stebenpe/MobileManipulator/besturingskast/README.md

# Besturingskast


## 1. Onderdelen
1. Omron NX-SL3300 1X
2. Omron NX-SID800 2X
3. Omron NX-SOD400 2X
4. Omron NX-EIC202 1X
5. Omron G7SA-2A2B DC24 met din-rail houder 6X
6. 12V 10A DC-DC converter 1X
7. 24V 5A DC-DC converter 1X
8. Kabelgoot 1X
9. NVIDIA Jetson AGX orin 1X

## 2. E-Plan
Voor de safety PLC, LD-90 en robot arm is een E-Plan tekening gemaakt. Deze is te vinden in de map e-plan.

## 3. Aanpassingen
In de stroom splitsing.docx is uitleg te vinden over de aanpassingen van de voeding splitsing voor de robot arm. Hier staan ook de benodigde onderdelen daarvoor in.
