stebenpe/MobileManipulator/images/programma-overzicht.jpg

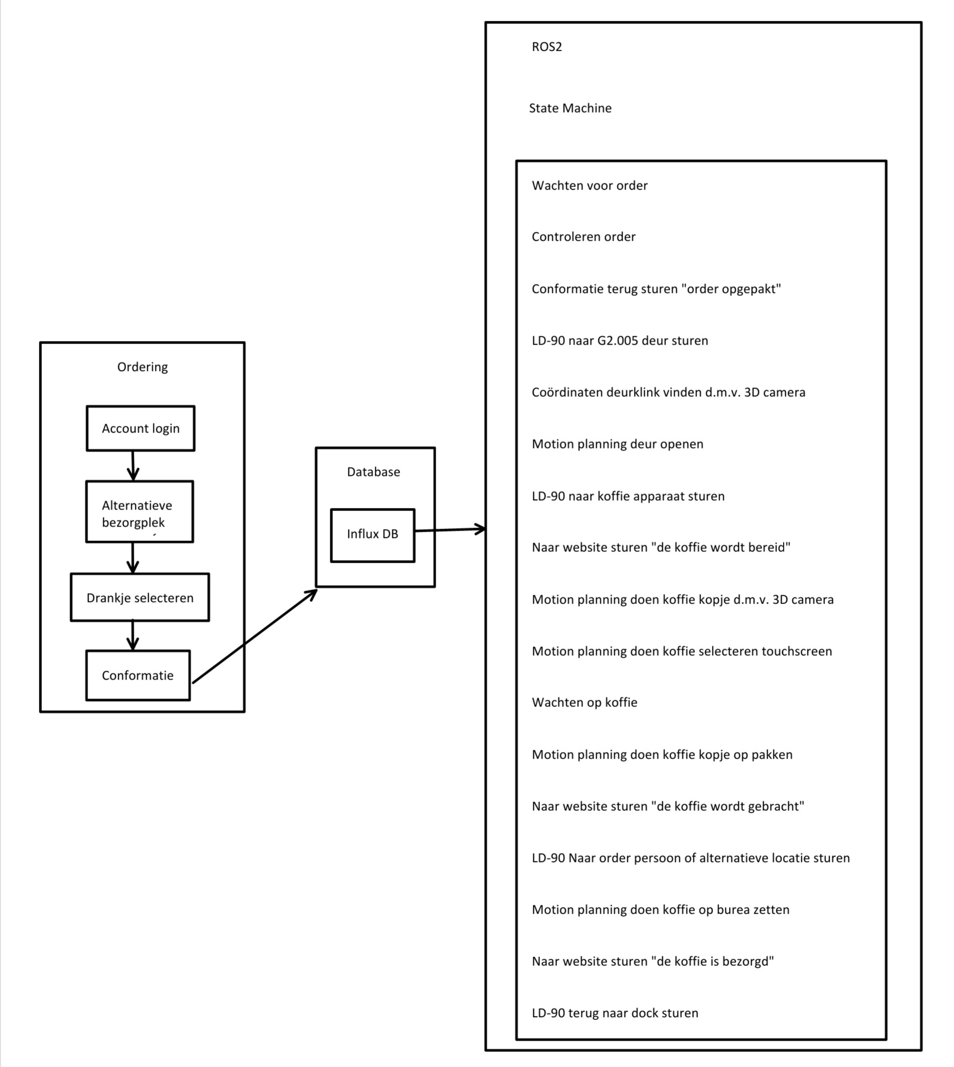
images/programma-overzicht.jpg
