stebenpe/MobileManipulator/maak onderdelen/3D prints/sensor blok M V1.2.STL

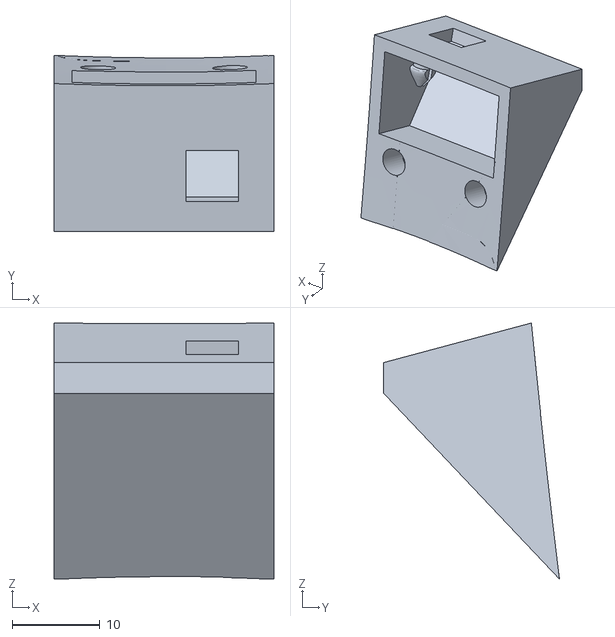
[picture p22: CAD file, 2023-12-12, last stored version]
maak onderdelen/3D prints/sensor blok M V1.2.STL
25.0 x 20.0 x 29.1
