stebenpe/MobileManipulator/maak onderdelen/watersnijden/top top plate ld90 6mm.DXF

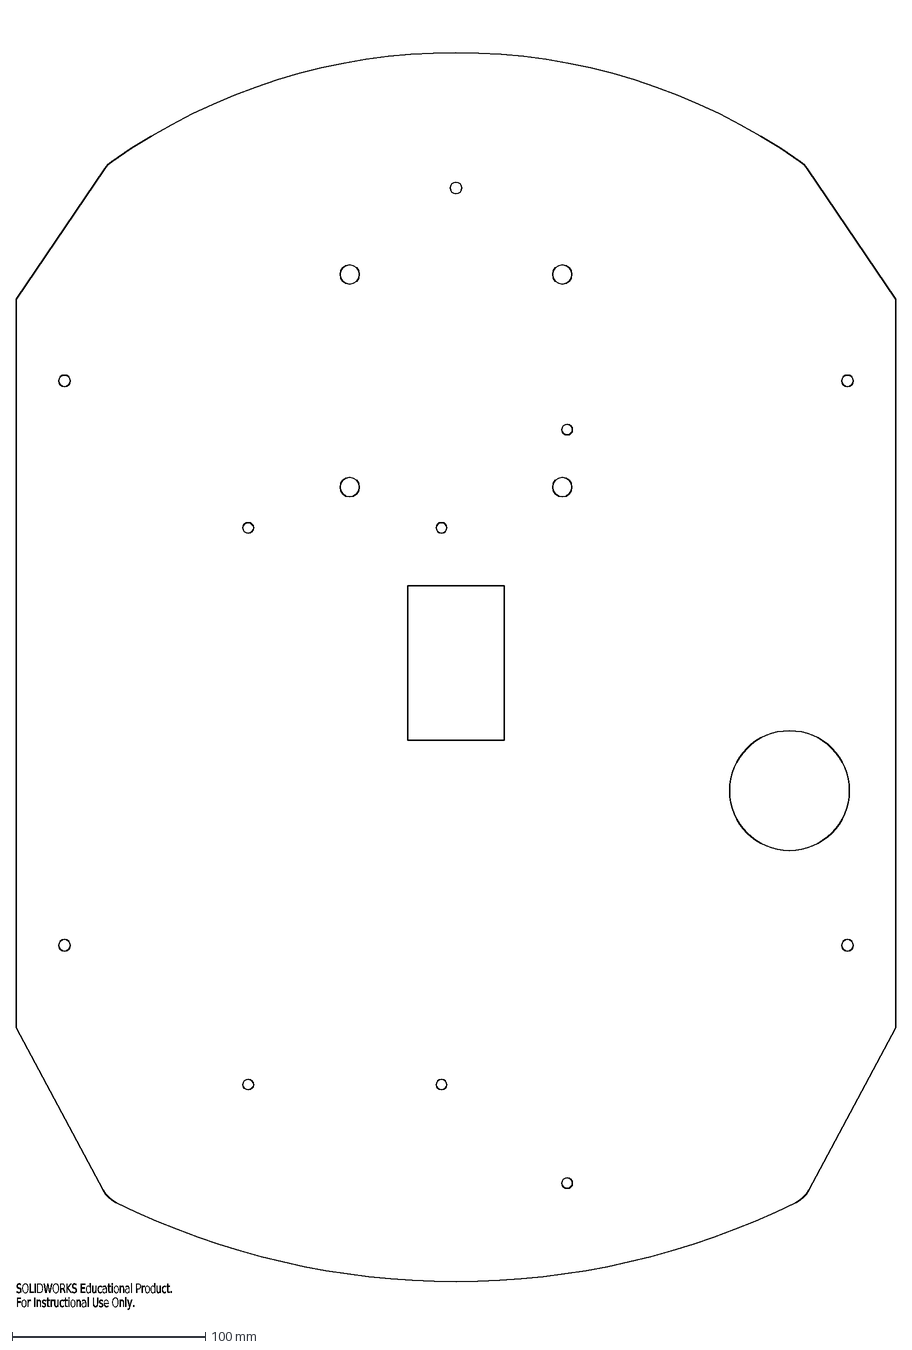
[picture p23: CAD file, 2023-12-11, last stored version]
maak onderdelen/watersnijden/top top plate ld90 6mm.DXF
SOLIDWORKS Educational Product.
For Instructional Use Only.
