stebenpe/MobileManipulator/ros2_ws/src/assets/end_effectors/robotiq_3f_gripper/robotiq_3f_gripper_description/meshes/robotiq-3f-gripper/collision/GRIPPER_OPEN_PALM.stl

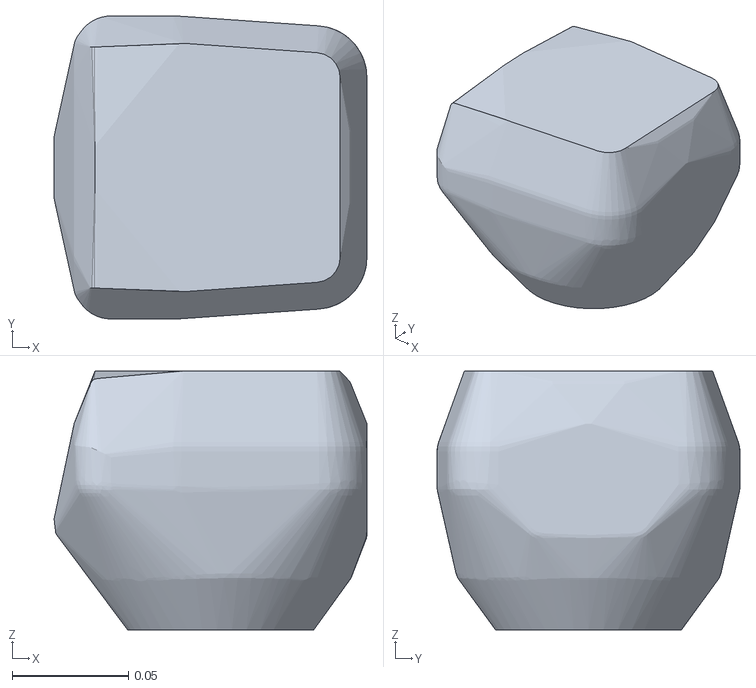
[picture p24: CAD file, 2023-12-11, last stored version]
ros2_ws/src/assets/end_effectors/robotiq_3f_gripper/robotiq_3f_gripper_description/meshes/robotiq-3f-gripper/collision/GRIPPER_OPEN_PALM.stl
0.134 x 0.13 x 0.111
