stebenpe/MobileManipulator/ros2_ws/src/assets/end_effectors/robotiq_3f_gripper/robotiq_3f_gripper_description/meshes/robotiq-3f-gripper/visual/GRIPPER_OPEN_FINGER_1.stl

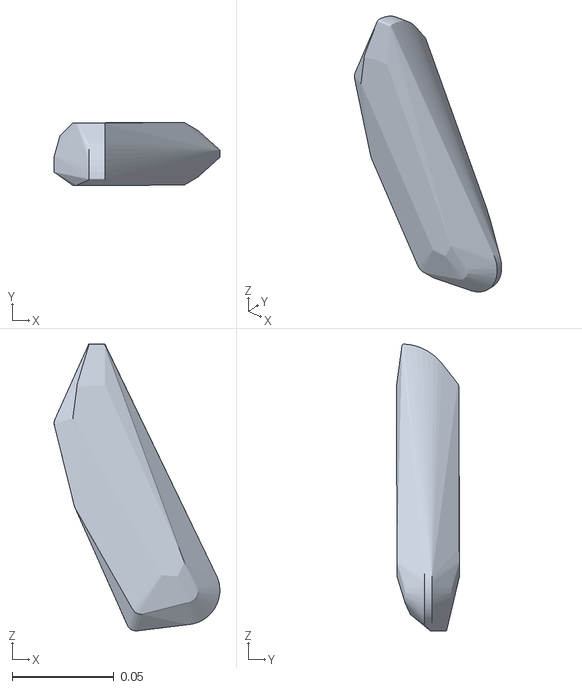
[picture p25: CAD file, 2023-12-11, last stored version]
ros2_ws/src/assets/end_effectors/robotiq_3f_gripper/robotiq_3f_gripper_description/meshes/robotiq-3f-gripper/visual/GRIPPER_OPEN_FINGER_1.stl
0.0815 x 0.031 x 0.141
