stebenpe/MobileManipulator/ros2_ws/src/assets/end_effectors/robotiq_3f_gripper/robotiq_3f_gripper_description/meshes/robotiq-3f-gripper_articulated/collision/link_0.STL

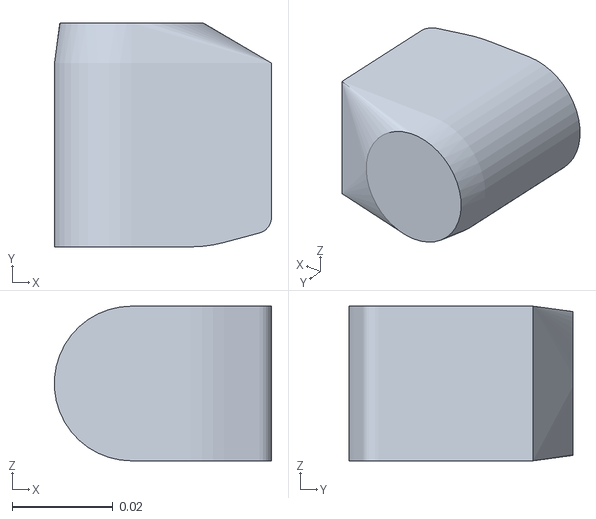
[picture p26: CAD file, 2023-12-11, last stored version]
ros2_ws/src/assets/end_effectors/robotiq_3f_gripper/robotiq_3f_gripper_description/meshes/robotiq-3f-gripper_articulated/collision/link_0.STL
0.0431 x 0.0444 x 0.0307
