stebenpe/MobileManipulator/ros2_ws/src/assets/end_effectors/robotiq_85_gripper/robotiq_85_description/meshes/collision/robotiq_85_base_link.stl

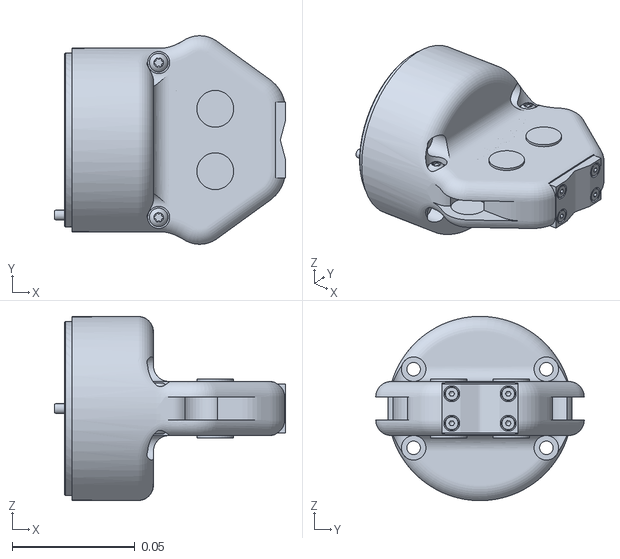
[picture p27: CAD file, 2023-12-11, last stored version]
ros2_ws/src/assets/end_effectors/robotiq_85_gripper/robotiq_85_description/meshes/collision/robotiq_85_base_link.stl
0.094 x 0.0849 x 0.075
