stebenpe/MobileManipulator/ros2_ws/src/assets/end_effectors/single_suction_gripper/single_suction_description/meshes/wrist_fixture.STL

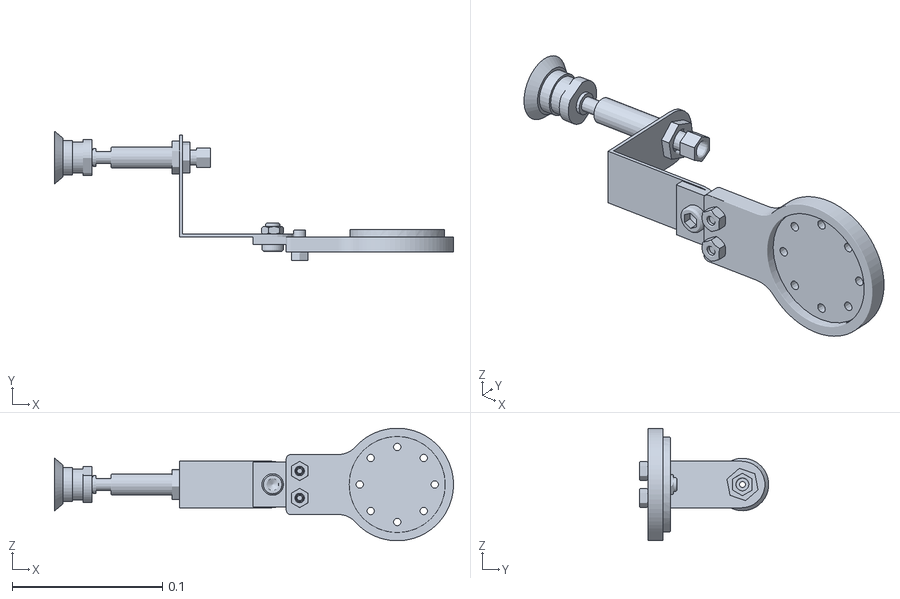
[picture p28: CAD file, 2023-12-11, last stored version]
ros2_ws/src/assets/end_effectors/single_suction_gripper/single_suction_description/meshes/wrist_fixture.STL
0.266 x 0.0862 x 0.0749
