stebenpe/MobileManipulator/ros2_ws/src/assets/robots/fanuc/fanuc_description/meshes/collision/link_1.stl

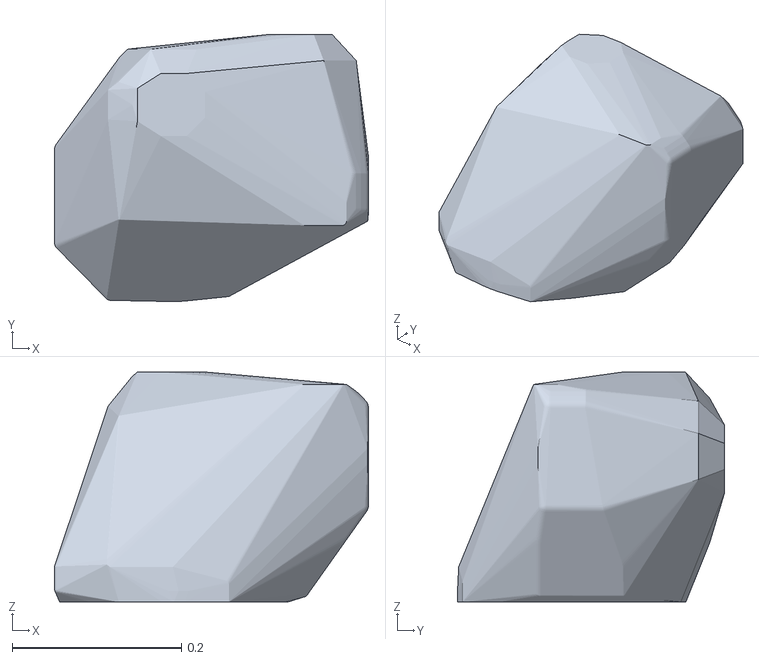
[picture p29: CAD file, 2023-12-11, last stored version]
ros2_ws/src/assets/robots/fanuc/fanuc_description/meshes/collision/link_1.stl
0.371 x 0.316 x 0.272
