stebenpe/MobileManipulator/ros2_ws/src/assets/robots/fanuc/fanuc_description/meshes/visual/link_2.stl

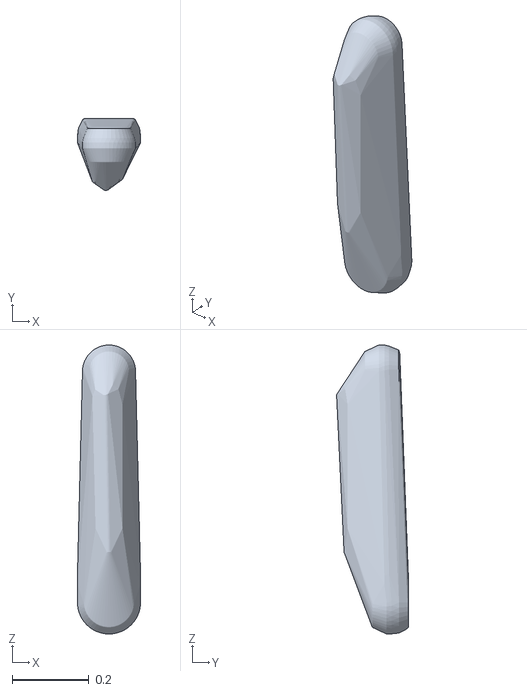
[picture p30: CAD file, 2023-12-11, last stored version]
ros2_ws/src/assets/robots/fanuc/fanuc_description/meshes/visual/link_2.stl
0.164 x 0.187 x 0.751
