stebenpe/MobileManipulator/ros2_ws/src/assets/robots/panda_robot/panda_description/meshes/collision/link1.stl

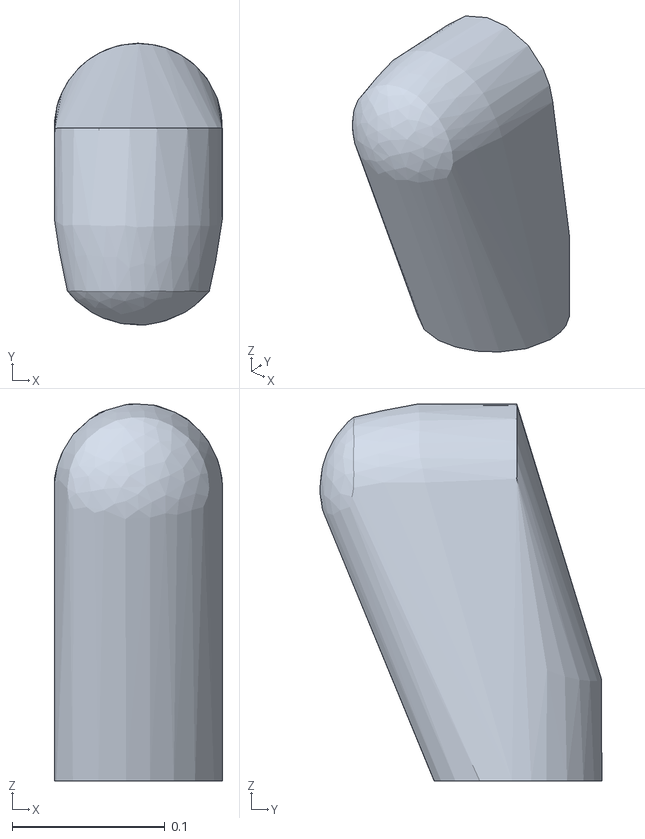
[picture p31: CAD file, 2023-12-11, last stored version]
ros2_ws/src/assets/robots/panda_robot/panda_description/meshes/collision/link1.stl
0.11 x 0.185 x 0.247
