stebenpe/MobileManipulator/ros2_ws/src/assets/robots/universal_robot/ur_description/meshes/ur10/collision/wrist2.stl

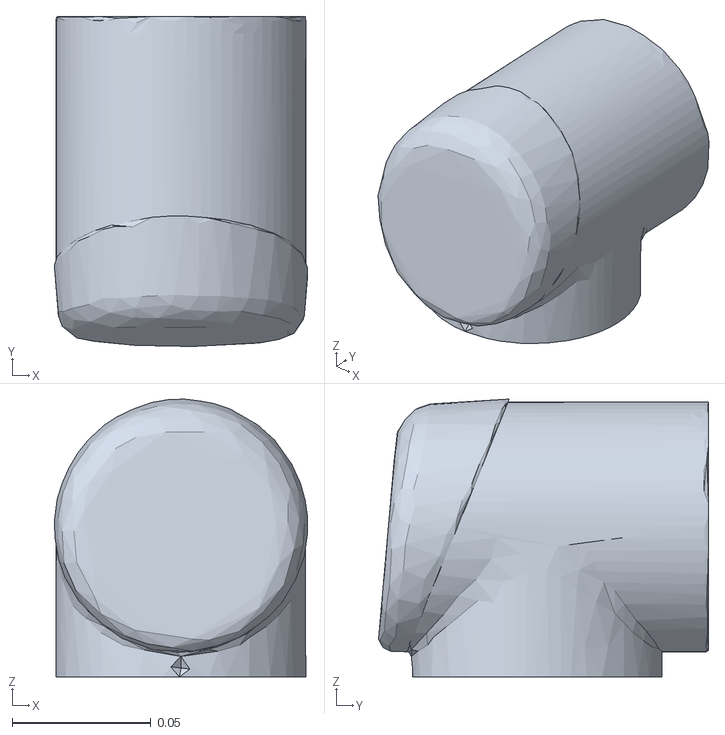
[picture p32: CAD file, 2023-12-11, last stored version]
ros2_ws/src/assets/robots/universal_robot/ur_description/meshes/ur10/collision/wrist2.stl
0.0913 x 0.119 x 0.1
