stebenpe/MobileManipulator/ros2_ws/src/assets/robots/universal_robot/ur_description/meshes/ur3/collision/shoulder.stl

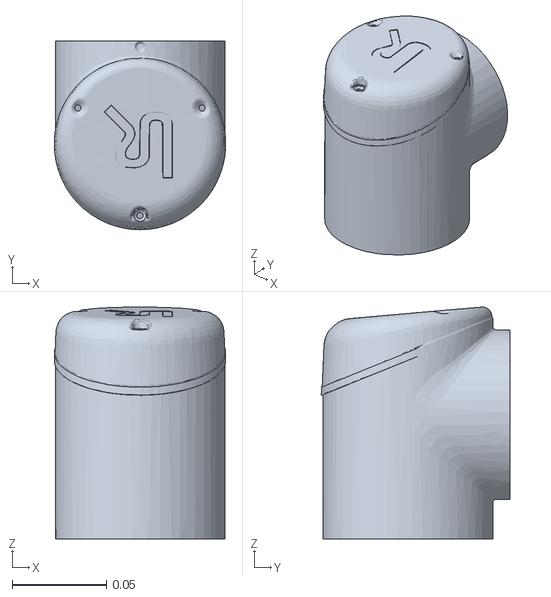
[picture p33: CAD file, 2023-12-11, last stored version]
ros2_ws/src/assets/robots/universal_robot/ur_description/meshes/ur3/collision/shoulder.stl
0.0909 x 0.0999 x 0.123
