stebenpe/MobileManipulator/ros2_ws/src/assets/robots/universal_robot/ur_description/meshes/ur5/collision/wrist3.stl

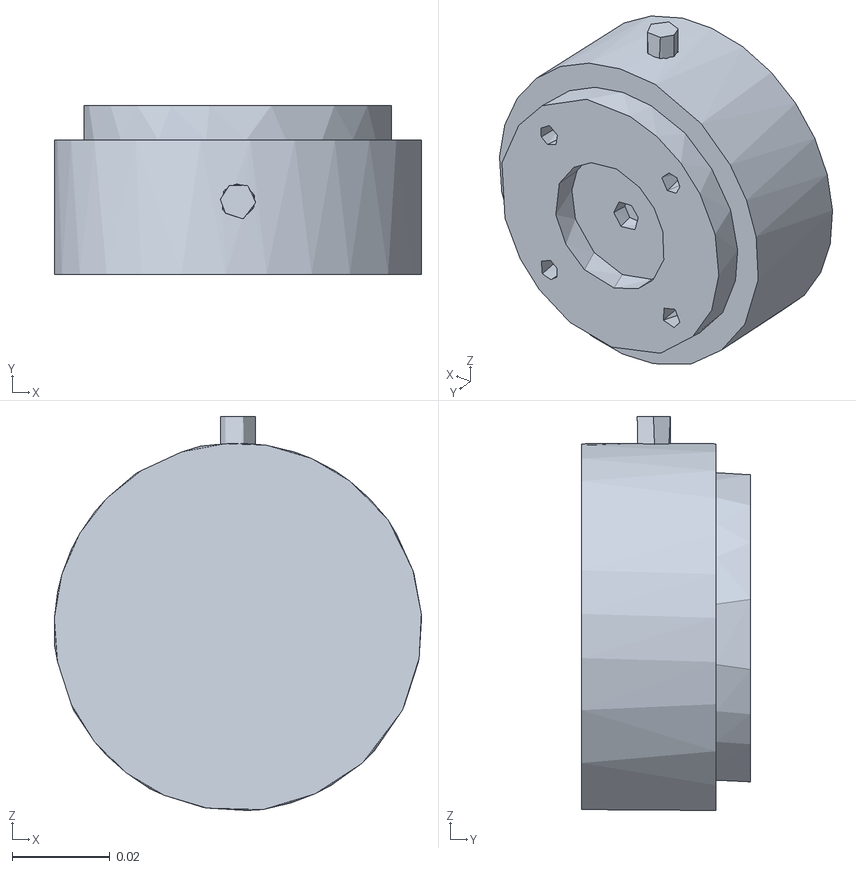
[picture p34: CAD file, 2023-12-11, last stored version]
ros2_ws/src/assets/robots/universal_robot/ur_description/meshes/ur5/collision/wrist3.stl
0.075 x 0.0345 x 0.0805
