stebenpe/MobileManipulator/ros2_ws/src/omron_moma/robot_description/meshes/chassis/chassis.stl

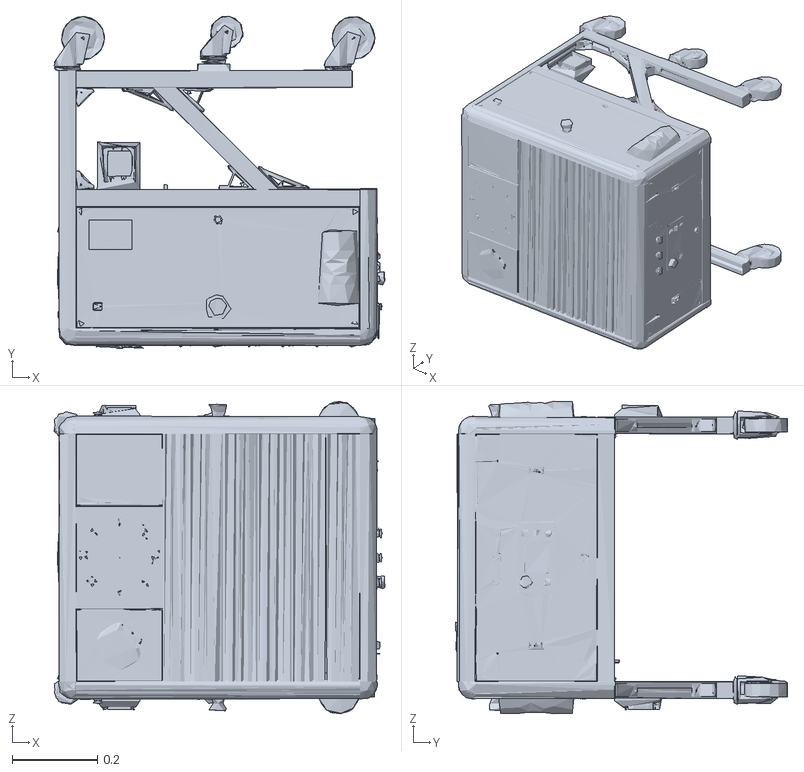
[picture p35: CAD file, 2023-12-11, last stored version]
ros2_ws/src/omron_moma/robot_description/meshes/chassis/chassis.stl
0.775 x 0.778 x 0.732
