stebenpe/MobileManipulator/ros2_ws/src/omron_moma/robot_description/meshes/gripper/robotiq/2f-85/robotiq_85_gripper.stl

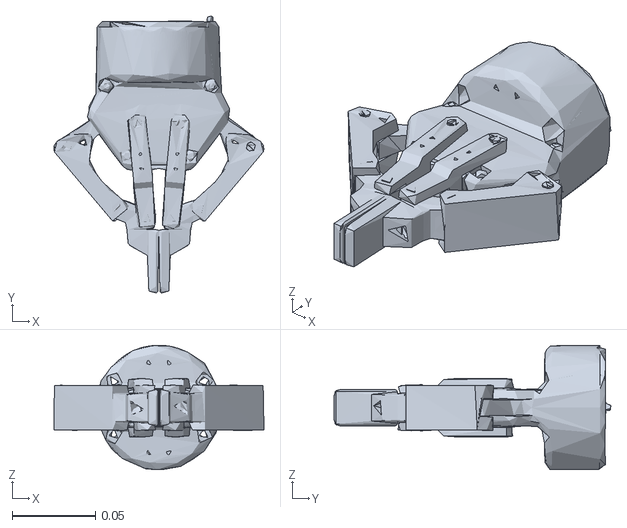
[picture p36: CAD file, 2023-12-11, last stored version]
ros2_ws/src/omron_moma/robot_description/meshes/gripper/robotiq/2f-85/robotiq_85_gripper.stl
0.126 x 0.166 x 0.0747
