stebenpe/MobileManipulator/ros2_ws/src/omron_moma/robot_description/meshes/tm5-900/collision/tmr_100w_02_c.stl

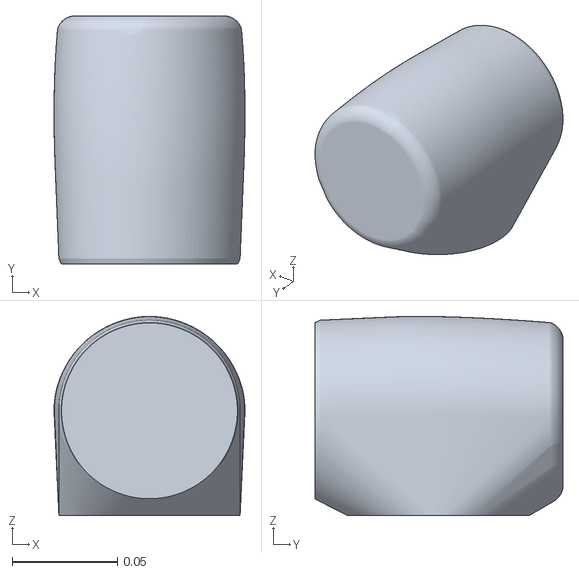
[picture p37: CAD file, 2023-12-11, last stored version]
ros2_ws/src/omron_moma/robot_description/meshes/tm5-900/collision/tmr_100w_02_c.stl
0.0906 x 0.118 x 0.0945
