stebenpe/MobileManipulator/ros2_ws/src/omron_moma/robot_description/meshes/tm5-900/visual/tm5-900_arm2.stl

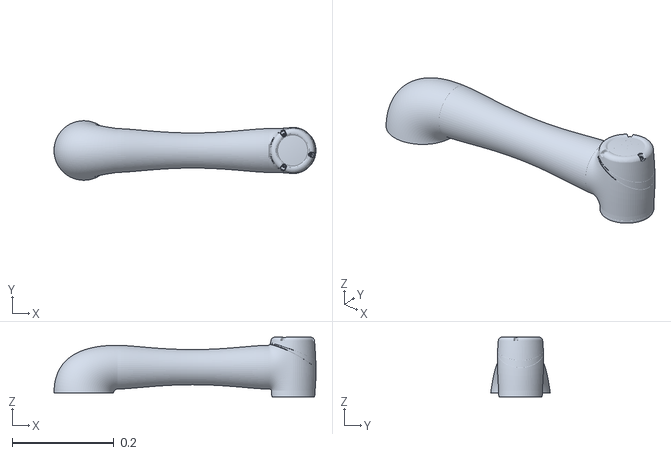
[picture p38: CAD file, 2023-12-11, last stored version]
ros2_ws/src/omron_moma/robot_description/meshes/tm5-900/visual/tm5-900_arm2.stl
0.515 x 0.117 x 0.118
