stebenpe/MobileManipulator/ros2_ws/src/TM5/src/tm_models/meshes/tm12_1300/visual/tm12_arm2.stl

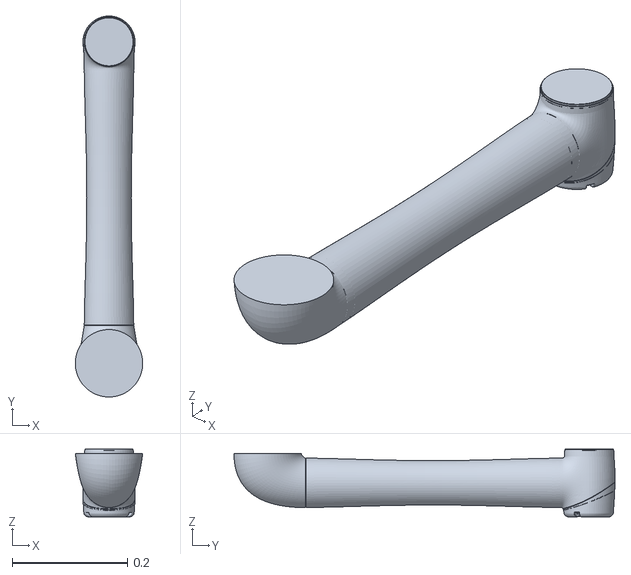
[picture p39: CAD file, 2023-12-11, last stored version]
ros2_ws/src/TM5/src/tm_models/meshes/tm12_1300/visual/tm12_arm2.stl
0.117 x 0.661 x 0.118
