stebenpe/MobileManipulator/ros2_ws/src/TM5/src/tm_models/meshes/tm5_700/collision/tm5_700_arm1_c.STL

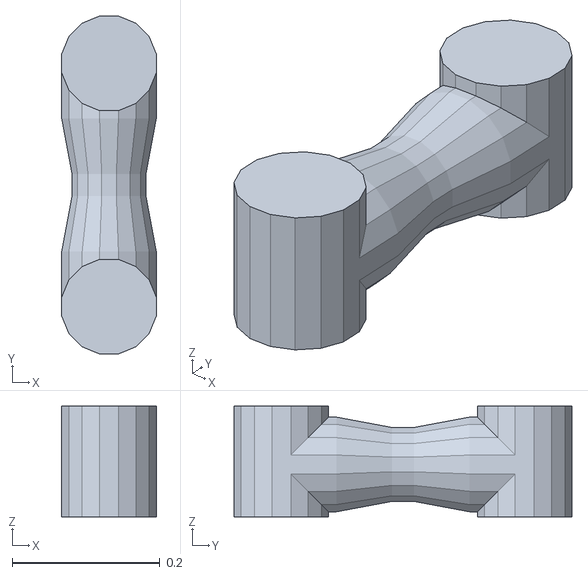
[picture p40: CAD file, 2023-12-11, last stored version]
ros2_ws/src/TM5/src/tm_models/meshes/tm5_700/collision/tm5_700_arm1_c.STL
0.128 x 0.457 x 0.15
