stebenpe/MobileManipulator/ros2_ws/src/TM5/src/tm_models/meshes/tm5_700/visual/tm5_700_arm2.stl

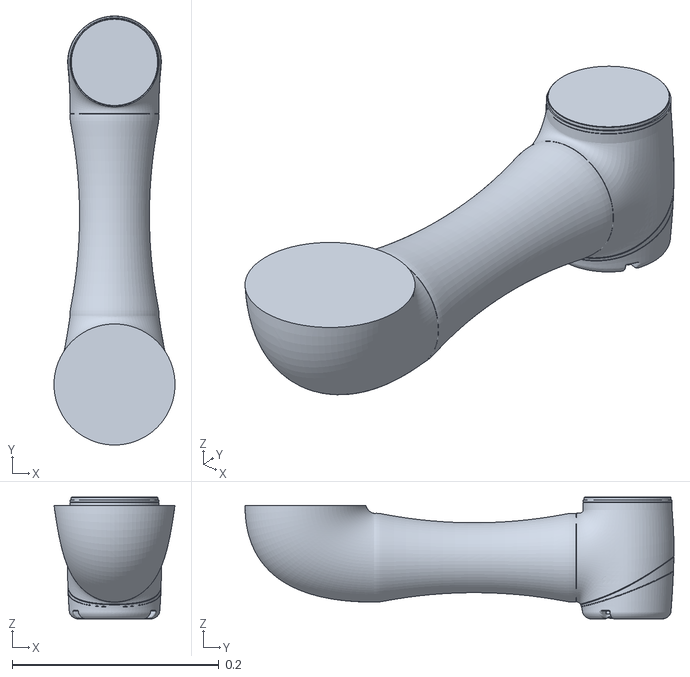
[picture p41: CAD file, 2023-12-11, last stored version]
ros2_ws/src/TM5/src/tm_models/meshes/tm5_700/visual/tm5_700_arm2.stl
0.117 x 0.415 x 0.118
