stebenpe/MobileManipulator/ros2_ws/src/TM5/src/tm_models/meshes/tm5_900/collision/tm_400w_01_c.STL

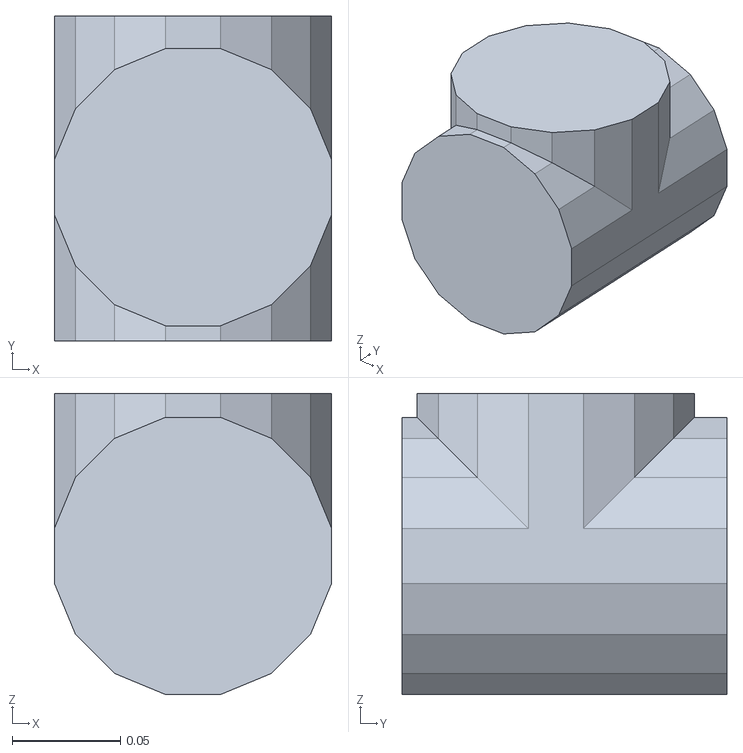
[picture p42: CAD file, 2023-12-11, last stored version]
ros2_ws/src/TM5/src/tm_models/meshes/tm5_900/collision/tm_400w_01_c.STL
0.128 x 0.15 x 0.139
