stebenpe/MobileManipulator/ros2_ws/src/TM5/src/tm_models/meshes/tm5_900/visual/tm5_base.stl

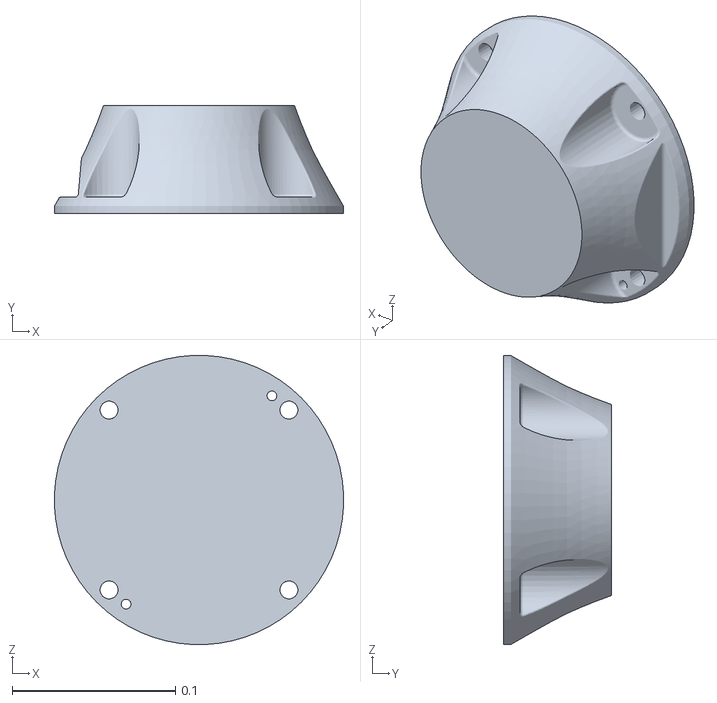
[picture p43: CAD file, 2023-12-11, last stored version]
ros2_ws/src/TM5/src/tm_models/meshes/tm5_900/visual/tm5_base.stl
0.177 x 0.066 x 0.177
