stebenpe/MobileManipulator/ros2_ws/src/TM5/src/tmr_description/meshes/tm5-900/collision/tmr_ee_c.stl

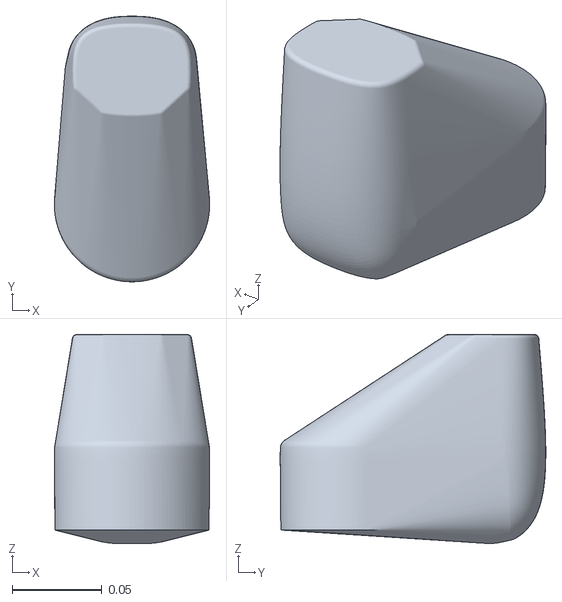
[picture p44: CAD file, 2023-12-11, last stored version]
ros2_ws/src/TM5/src/tmr_description/meshes/tm5-900/collision/tmr_ee_c.stl
0.0867 x 0.148 x 0.117
