stebenpe/MobileManipulator/ros2_ws/src/TM5/src/tmr_description/meshes/tm5-900/visual/tm5-900_arm2.stl

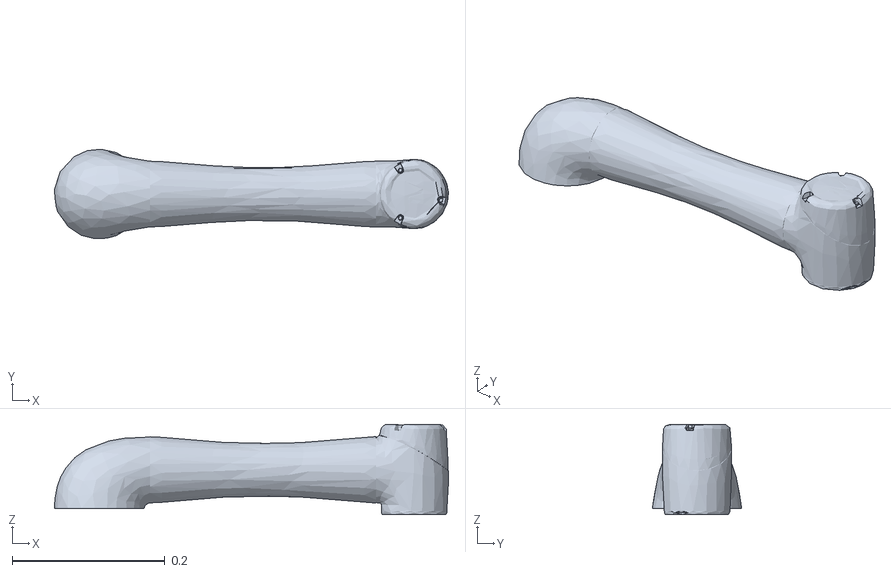
[picture p45: CAD file, 2023-12-11, last stored version]
ros2_ws/src/TM5/src/tmr_description/meshes/tm5-900/visual/tm5-900_arm2.stl
0.515 x 0.117 x 0.118
