stebenpe/MobileManipulator/ros2_ws/src/ZED/src/zed-ros2-wrapper/zed-ros2-interfaces/meshes/zed2.stl

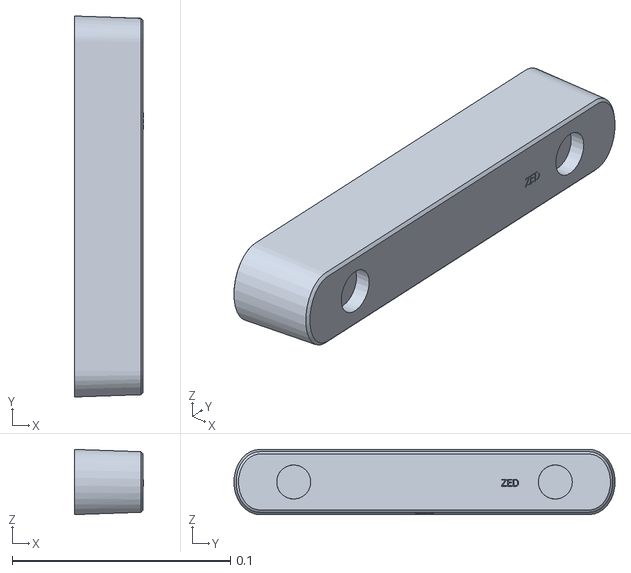
[picture p46: CAD file, 2023-12-11, last stored version]
ros2_ws/src/ZED/src/zed-ros2-wrapper/zed-ros2-interfaces/meshes/zed2.stl
0.0318 x 0.175 x 0.0299
