stebenpe/MobileManipulator/vue-webpanel/src/assets/out.ply

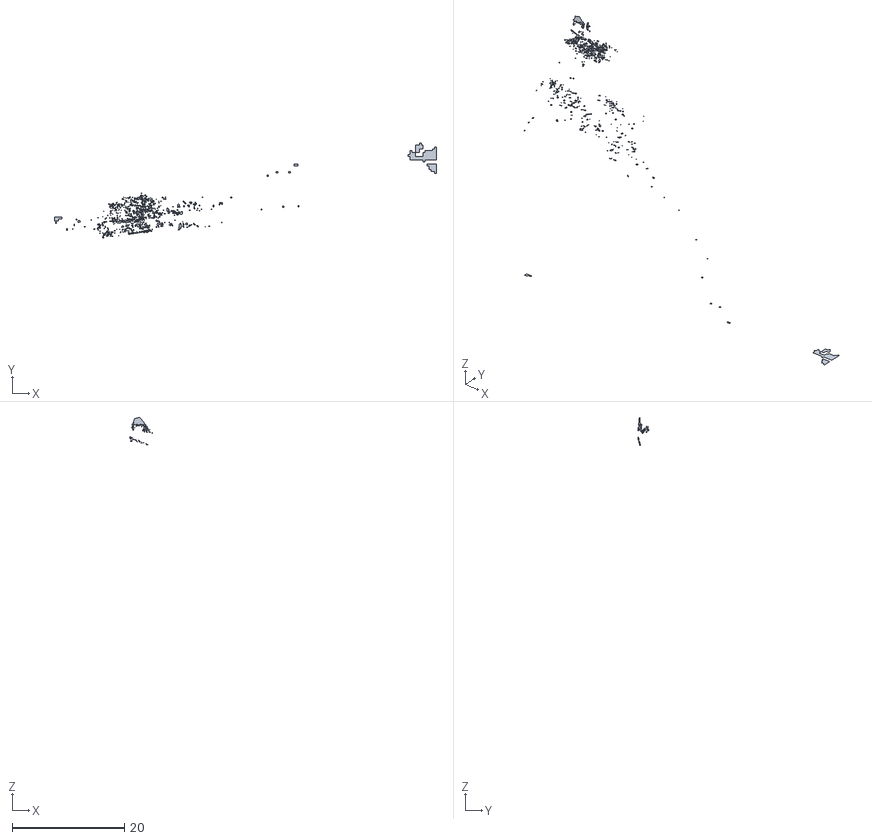
[picture p47: CAD file, 2023-12-11, last stored version]
vue-webpanel/src/assets/out.ply
68.1 x 16.9 x 65.0
