stebenpe/MobileManipulator/maak onderdelen/watersnijden/2X zei plaat 2mm.DXF

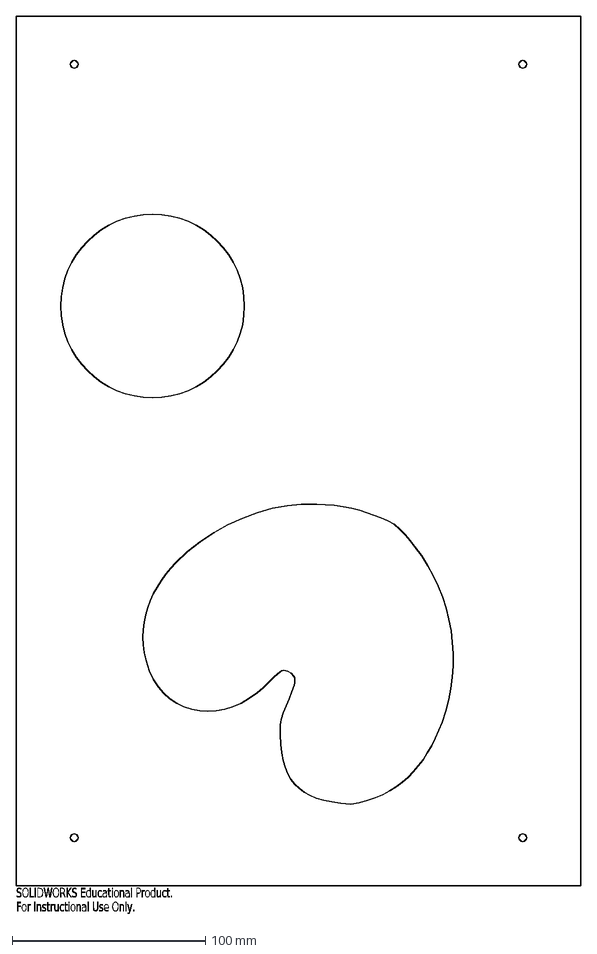
[picture p48: CAD file, 2023-12-11, last stored version]
maak onderdelen/watersnijden/2X zei plaat 2mm.DXF
SOLIDWORKS Educational Product.
For Instructional Use Only.
