stebenpe/MobileManipulator/ros2_ws/src/assets/end_effectors/robotiq_3f_gripper/robotiq_3f_gripper_description/meshes/robotiq-3f-gripper_articulated/collision/palm.STL

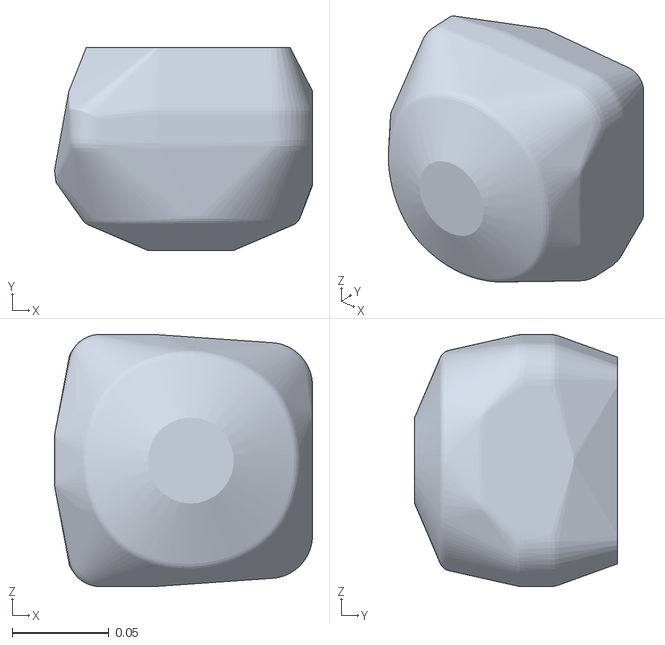
[picture p49: CAD file, 2023-12-11, last stored version]
ros2_ws/src/assets/end_effectors/robotiq_3f_gripper/robotiq_3f_gripper_description/meshes/robotiq-3f-gripper_articulated/collision/palm.STL
0.133 x 0.105 x 0.13
