stebenpe/MobileManipulator/ros2_ws/src/assets/end_effectors/robotiq_85_gripper/robotiq_85_description/meshes/collision/robotiq_85_inner_knuckle_link.stl

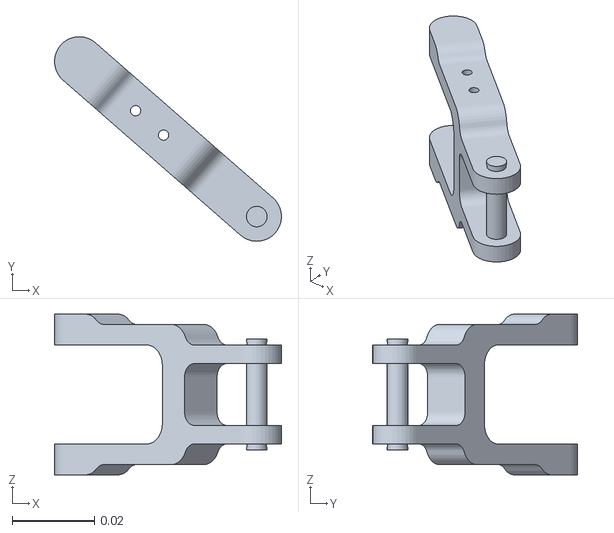
[picture p50: CAD file, 2023-12-11, last stored version]
ros2_ws/src/assets/end_effectors/robotiq_85_gripper/robotiq_85_description/meshes/collision/robotiq_85_inner_knuckle_link.stl
0.055 x 0.0496 x 0.039
