stebenpe/MobileManipulator/ros2_ws/src/assets/end_effectors/single_suction_gripper/single_suction_description/meshes/multiple_gripper_link.STL

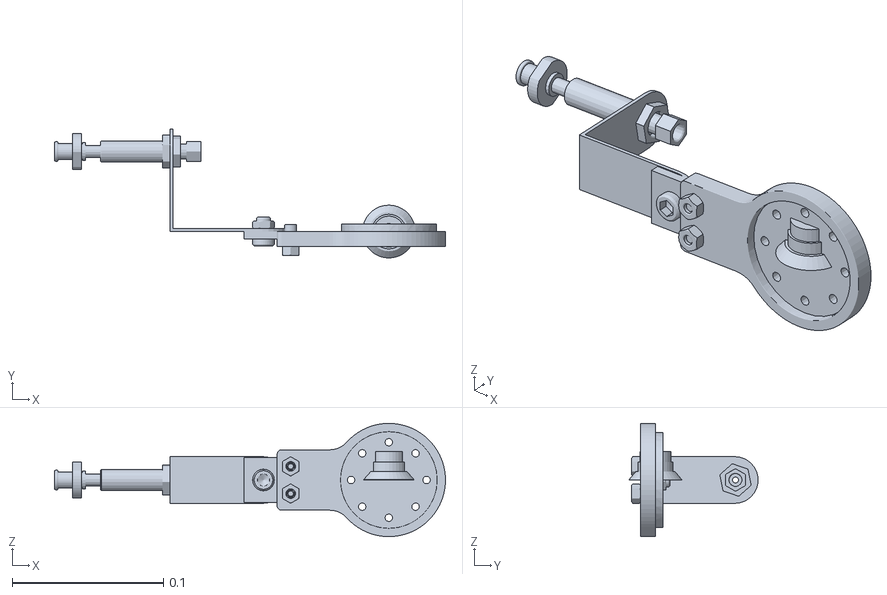
[picture p51: CAD file, 2023-12-11, last stored version]
ros2_ws/src/assets/end_effectors/single_suction_gripper/single_suction_description/meshes/multiple_gripper_link.STL
0.259 x 0.0854 x 0.0749
