stebenpe/MobileManipulator/ros2_ws/src/assets/robots/fanuc/fanuc_description/meshes/visual/link_5.stl

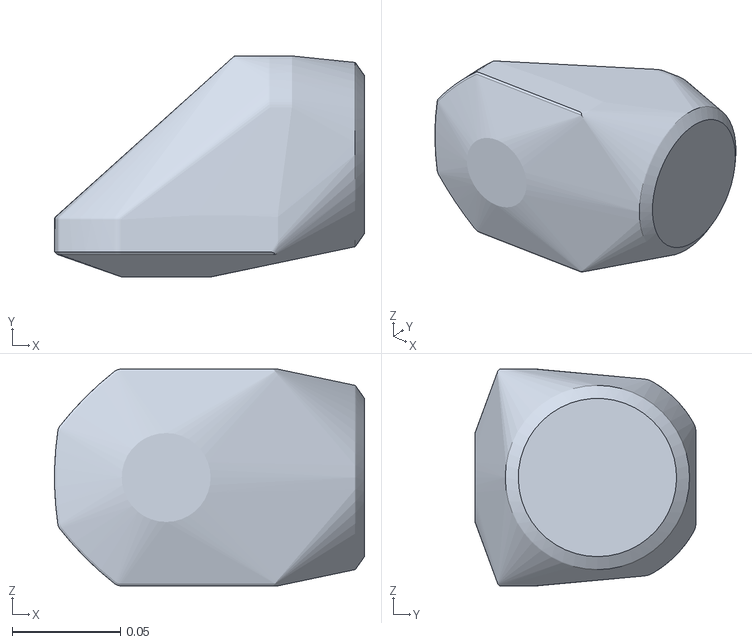
[picture p52: CAD file, 2023-12-11, last stored version]
ros2_ws/src/assets/robots/fanuc/fanuc_description/meshes/visual/link_5.stl
0.143 x 0.102 x 0.1
