stebenpe/MobileManipulator/ros2_ws/src/assets/robots/panda_robot/panda_description/meshes/collision/link3.stl

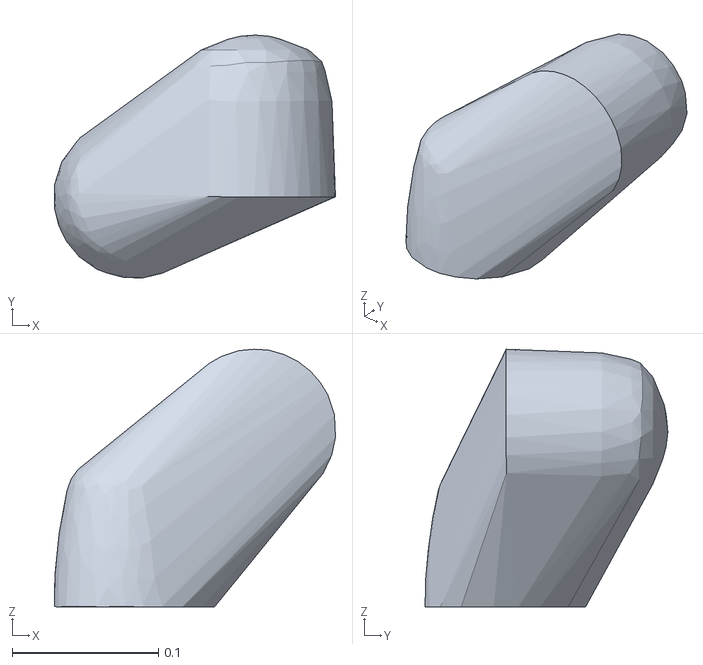
[picture p53: CAD file, 2023-12-11, last stored version]
ros2_ws/src/assets/robots/panda_robot/panda_description/meshes/collision/link3.stl
0.192 x 0.166 x 0.176
