stebenpe/MobileManipulator/ros2_ws/src/assets/robots/universal_robot/ur_description/meshes/ur10/collision/upperarm.stl

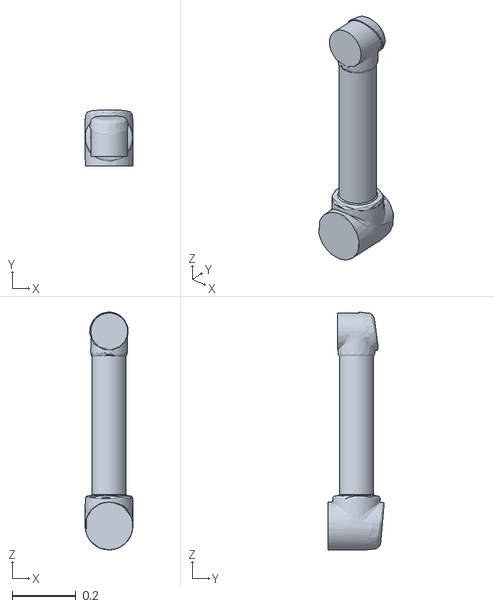
[picture p54: CAD file, 2023-12-11, last stored version]
ros2_ws/src/assets/robots/universal_robot/ur_description/meshes/ur10/collision/upperarm.stl
0.151 x 0.177 x 0.749
