stebenpe/MobileManipulator/ros2_ws/src/assets/robots/universal_robot/ur_description/meshes/ur3/collision/wrist2.stl

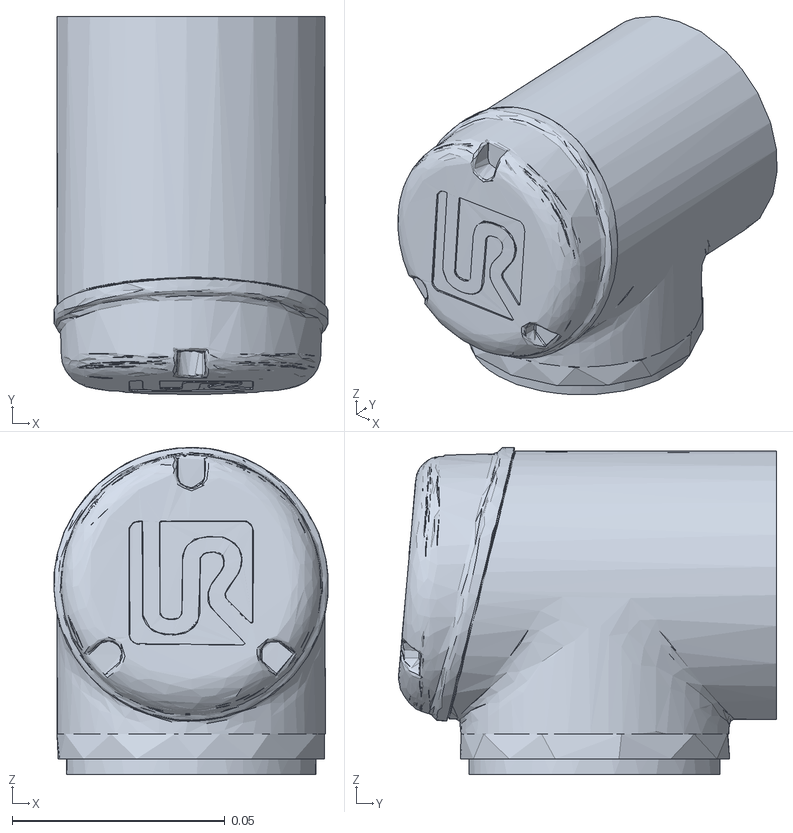
[picture p55: CAD file, 2023-12-11, last stored version]
ros2_ws/src/assets/robots/universal_robot/ur_description/meshes/ur3/collision/wrist2.stl
0.0643 x 0.0887 x 0.0768
