stebenpe/MobileManipulator/ros2_ws/src/assets/robots/universal_robot/ur_description/meshes/ur5/collision/wrist1.stl

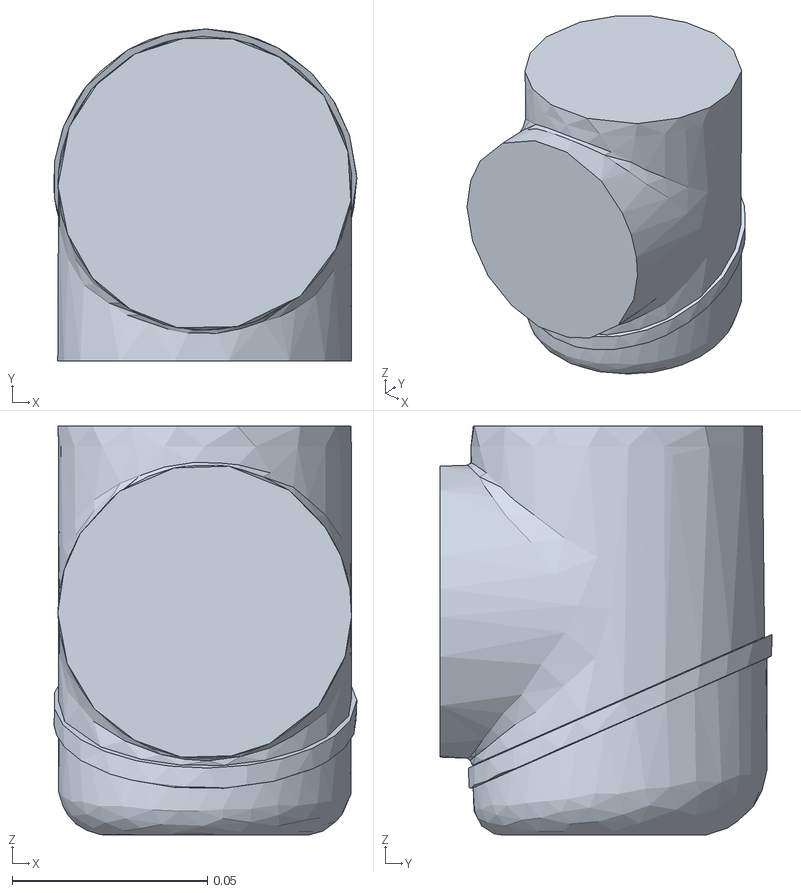
[picture p56: CAD file, 2023-12-11, last stored version]
ros2_ws/src/assets/robots/universal_robot/ur_description/meshes/ur5/collision/wrist1.stl
0.0775 x 0.085 x 0.105
