stebenpe/MobileManipulator/ros2_ws/src/omron_moma/robot_description/meshes/tm5-900/collision/tm5-900_arm1_c.stl

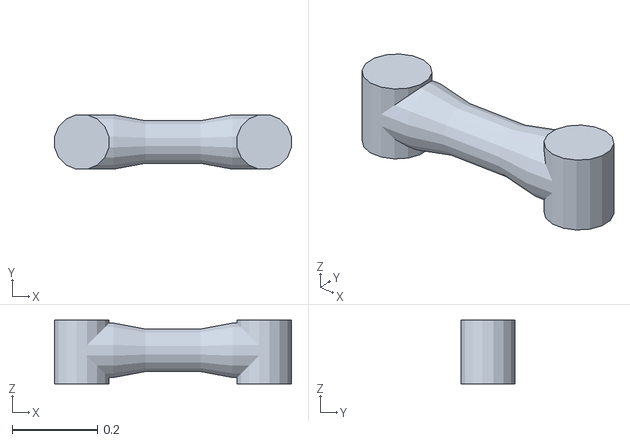
[picture p57: CAD file, 2023-12-11, last stored version]
ros2_ws/src/omron_moma/robot_description/meshes/tm5-900/collision/tm5-900_arm1_c.stl
0.557 x 0.128 x 0.15
