stebenpe/MobileManipulator/ros2_ws/src/TM5/src/tm_models/meshes/tm12_1300/collision/tm12_arm2_c.STL

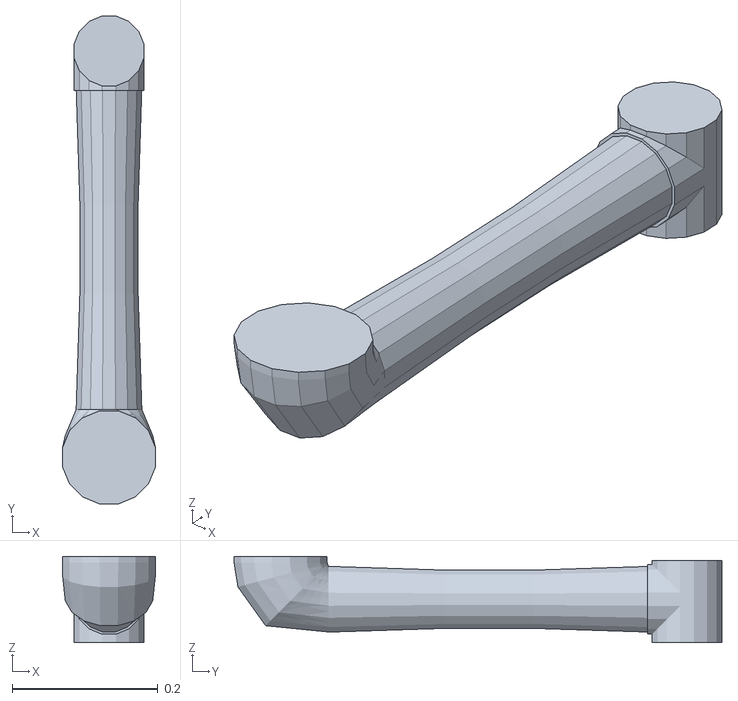
[picture p58: CAD file, 2023-12-11, last stored version]
ros2_ws/src/TM5/src/tm_models/meshes/tm12_1300/collision/tm12_arm2_c.STL
0.128 x 0.67 x 0.118
