stebenpe/MobileManipulator/ros2_ws/src/TM5/src/tm_models/meshes/tm12_1300/visual/tm_750w_01.stl

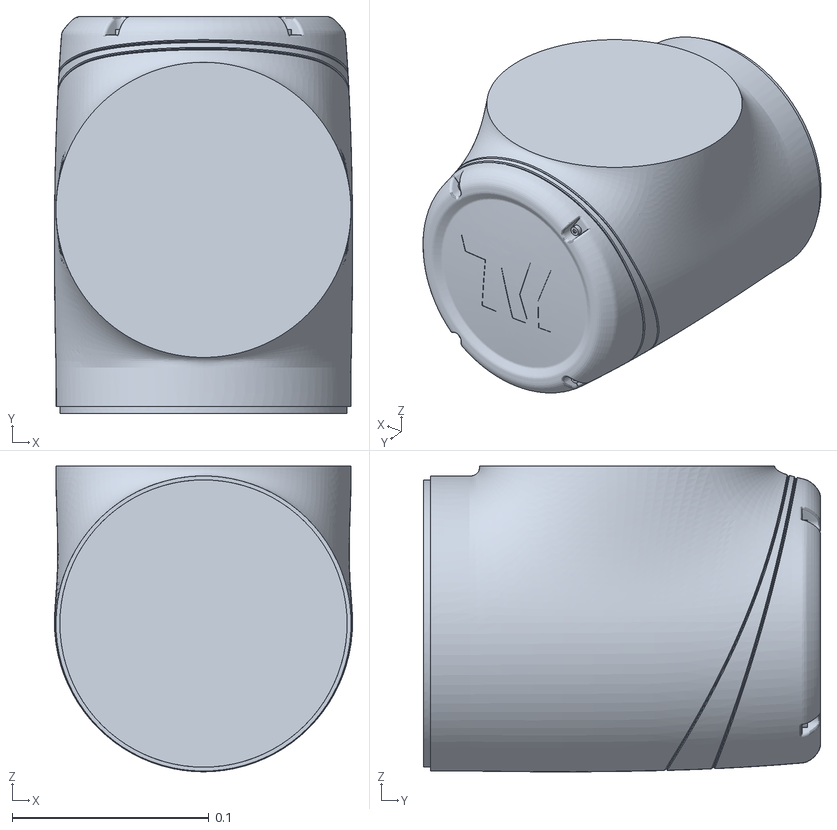
[picture p59: CAD file, 2023-12-11, last stored version]
ros2_ws/src/TM5/src/tm_models/meshes/tm12_1300/visual/tm_750w_01.stl
0.152 x 0.202 x 0.155
