stebenpe/MobileManipulator/ros2_ws/src/TM5/src/tm_models/meshes/tm5_700/collision/tm5_700_arm2_c.STL

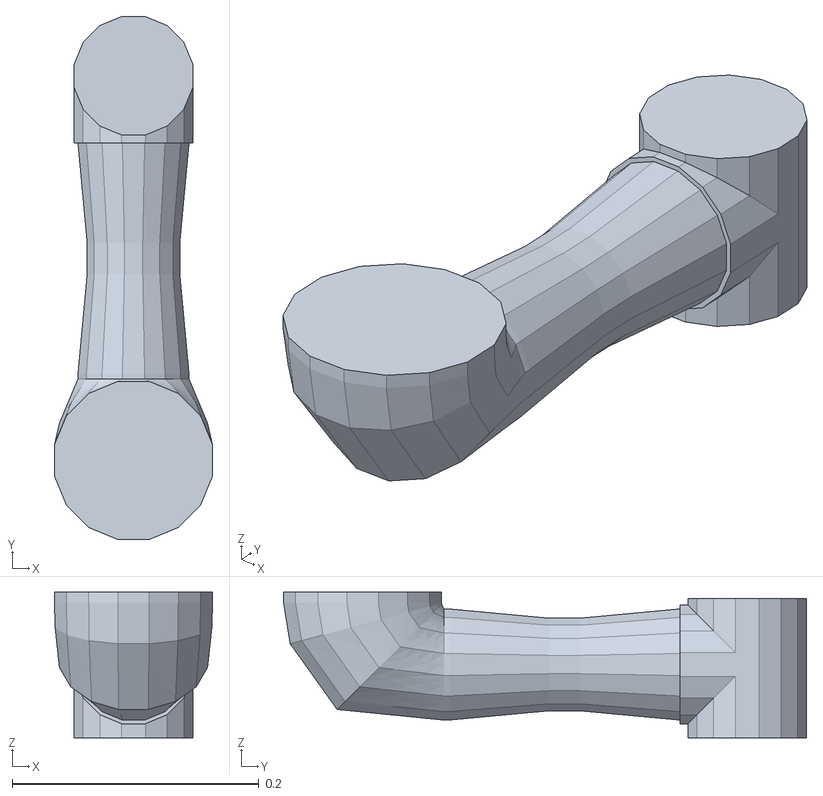
[picture p60: CAD file, 2023-12-11, last stored version]
ros2_ws/src/TM5/src/tm_models/meshes/tm5_700/collision/tm5_700_arm2_c.STL
0.128 x 0.423 x 0.118
