stebenpe/MobileManipulator/ros2_ws/src/TM5/src/tm_models/meshes/tm5_700/visual/tm5_700_arm1.stl

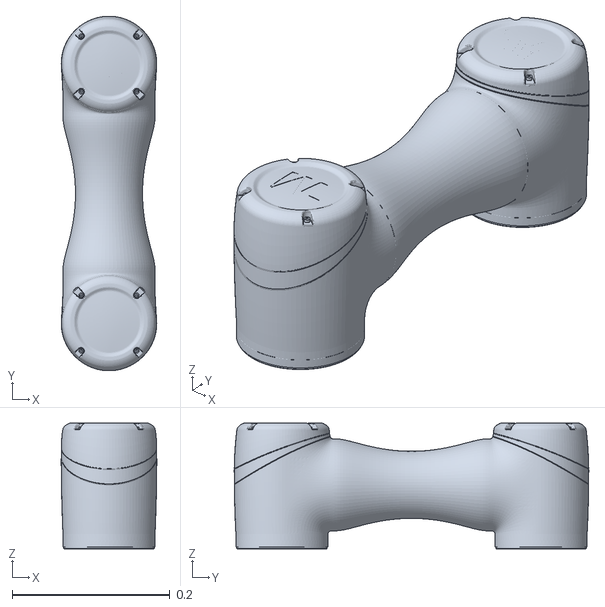
[picture p61: CAD file, 2023-12-11, last stored version]
ros2_ws/src/TM5/src/tm_models/meshes/tm5_700/visual/tm5_700_arm1.stl
0.121 x 0.45 x 0.16
