stebenpe/MobileManipulator/ros2_ws/src/TM5/src/tm_models/meshes/tm5_900/collision/tm5_900_arm2_c.STL

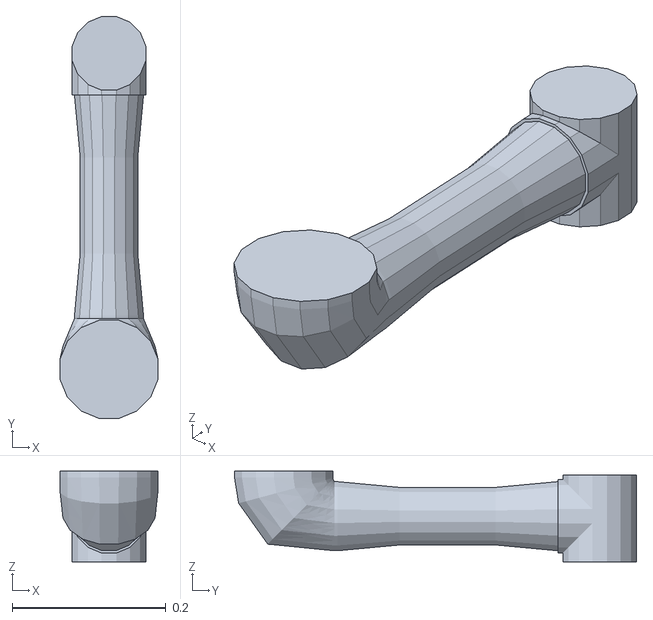
[picture p62: CAD file, 2023-12-11, last stored version]
ros2_ws/src/TM5/src/tm_models/meshes/tm5_900/collision/tm5_900_arm2_c.STL
0.128 x 0.524 x 0.118
