stebenpe/MobileManipulator/ros2_ws/src/TM5/src/tm_models/meshes/tm5_900/visual/tm_ee.stl

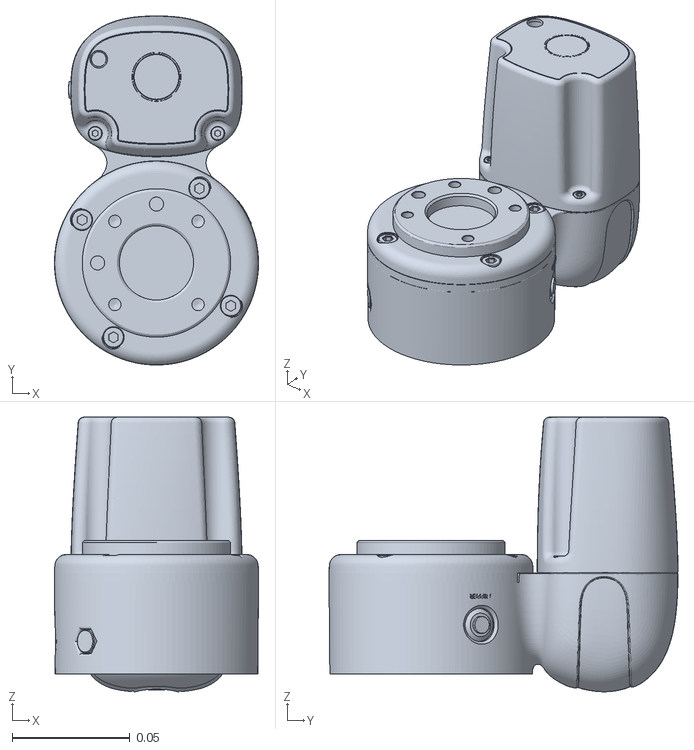
[picture p63: CAD file, 2023-12-11, last stored version]
ros2_ws/src/TM5/src/tm_models/meshes/tm5_900/visual/tm_ee.stl
0.0867 x 0.148 x 0.117
