stebenpe/MobileManipulator/ros2_ws/src/TM5/src/tmr_description/meshes/tm5-900/visual/tmr_100w_02.stl

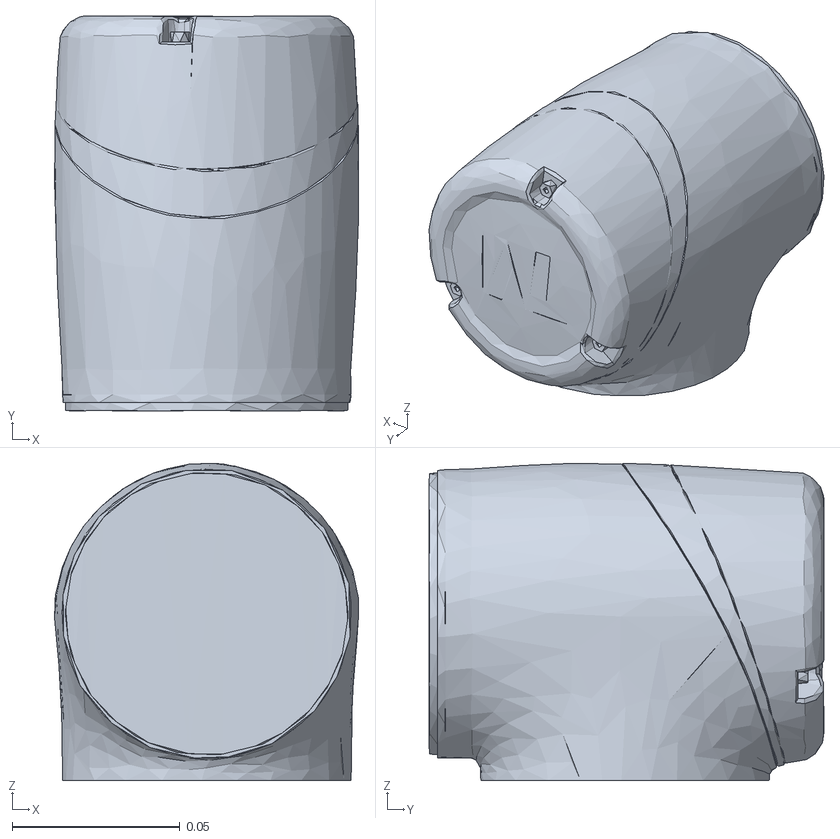
[picture p64: CAD file, 2023-12-11, last stored version]
ros2_ws/src/TM5/src/tmr_description/meshes/tm5-900/visual/tmr_100w_02.stl
0.0905 x 0.118 x 0.0945
