stebenpe/MobileManipulator/maak onderdelen/3D prints/sensor blok R V1.2.STL

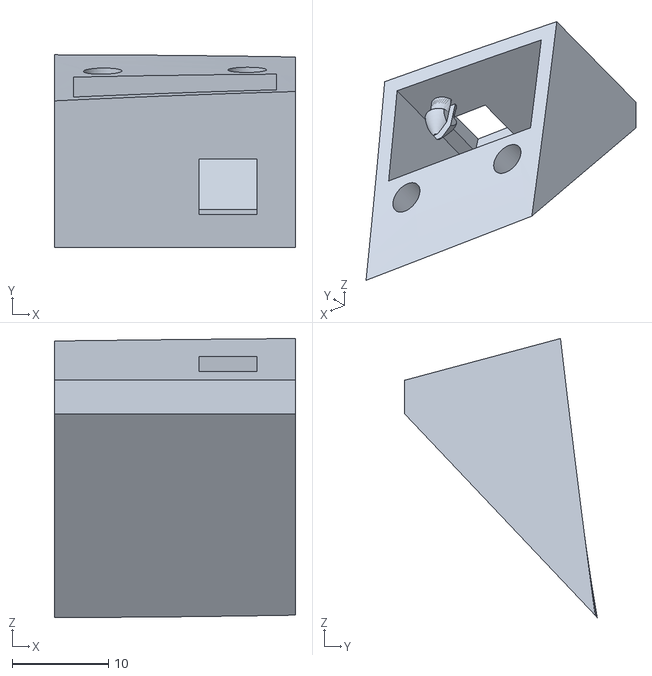
[picture p65: CAD file, 2023-12-12, last stored version]
maak onderdelen/3D prints/sensor blok R V1.2.STL
25.0 x 20.0 x 28.9
