stebenpe/MobileManipulator/maak onderdelen/watersnijden/2X side laser holder 2mm.DXF

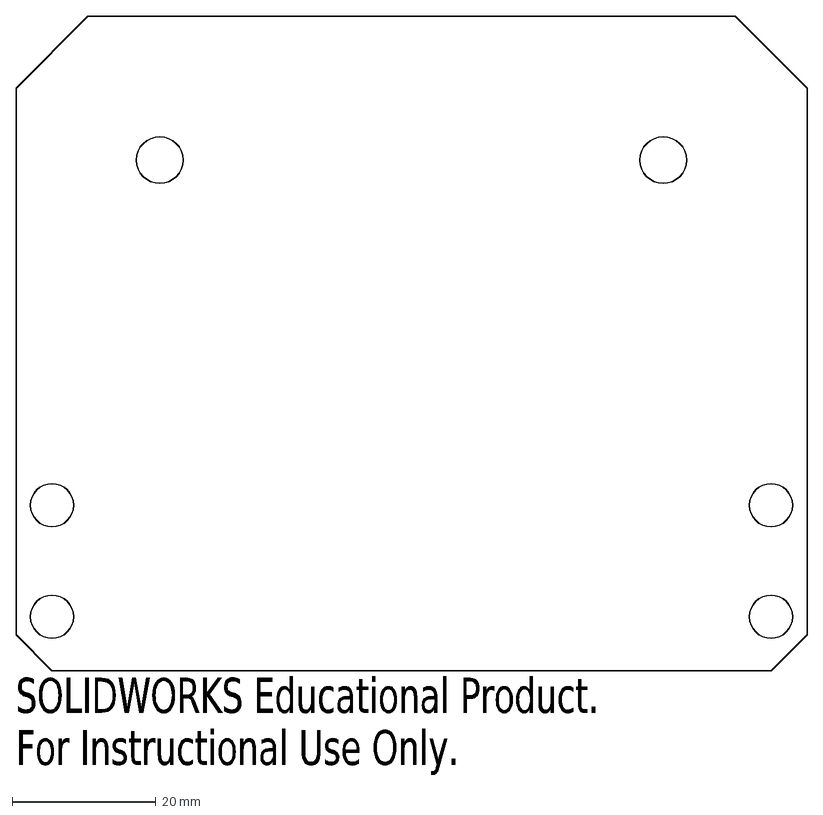
[picture p66: CAD file, 2023-12-11, last stored version]
maak onderdelen/watersnijden/2X side laser holder 2mm.DXF
SOLIDWORKS Educational Product.
For Instructional Use Only.
