stebenpe/MobileManipulator/ros2_ws/src/assets/end_effectors/robotiq_3f_gripper/robotiq_3f_gripper_description/meshes/robotiq-3f-gripper/visual/GRIPPER_OPEN.stl

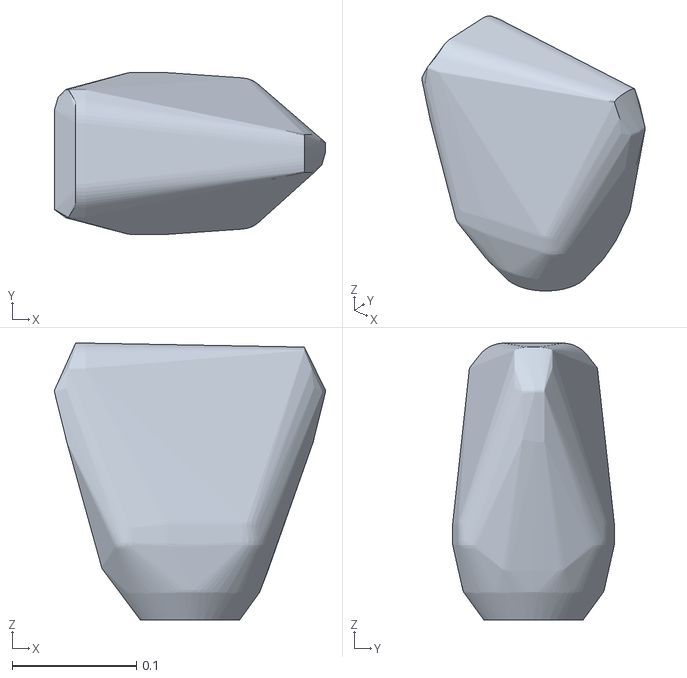
[picture p67: CAD file, 2023-12-11, last stored version]
ros2_ws/src/assets/end_effectors/robotiq_3f_gripper/robotiq_3f_gripper_description/meshes/robotiq-3f-gripper/visual/GRIPPER_OPEN.stl
0.218 x 0.13 x 0.223
