stebenpe/MobileManipulator/ros2_ws/src/assets/end_effectors/robotiq_85_gripper/robotiq_85_description/meshes/collision/robotiq_85_finger_link.stl

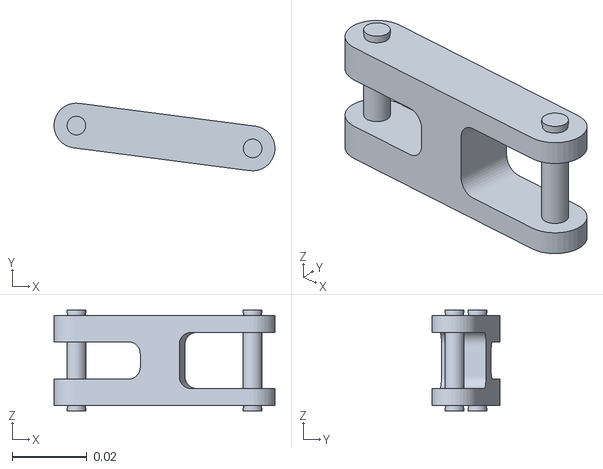
[picture p69: CAD file, 2023-12-11, last stored version]
ros2_ws/src/assets/end_effectors/robotiq_85_gripper/robotiq_85_description/meshes/collision/robotiq_85_finger_link.stl
0.0591 x 0.0181 x 0.027
