stebenpe/MobileManipulator/ros2_ws/src/assets/end_effectors/single_suction_gripper/single_suction_description/meshes/suction_cup_link.STL

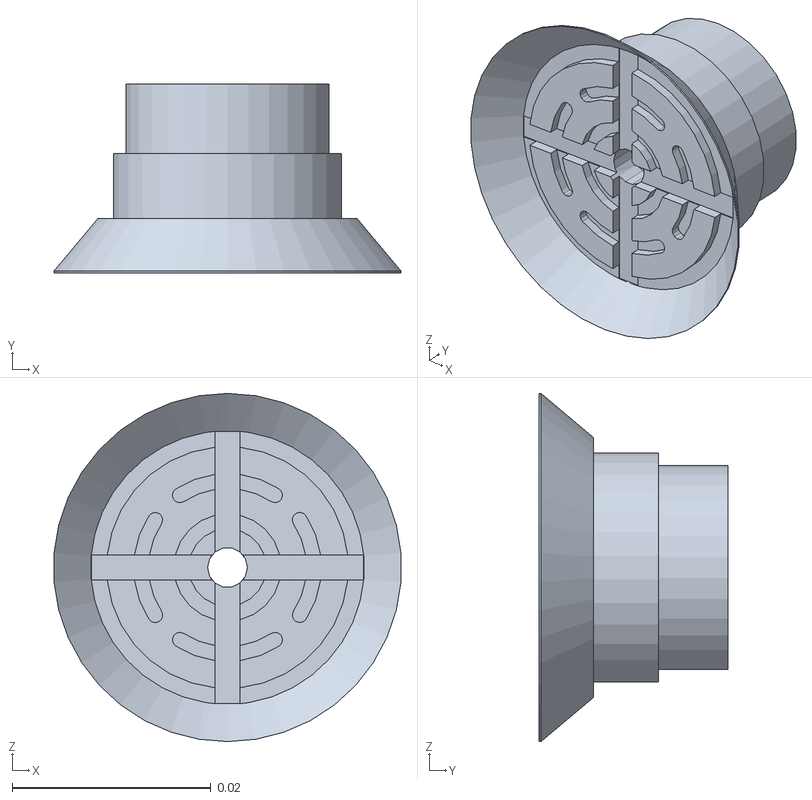
[picture p70: CAD file, 2023-12-11, last stored version]
ros2_ws/src/assets/end_effectors/single_suction_gripper/single_suction_description/meshes/suction_cup_link.STL
0.0349 x 0.019 x 0.035
