stebenpe/MobileManipulator/ros2_ws/src/assets/robots/fanuc/fanuc_description/meshes/collision/link_6.stl

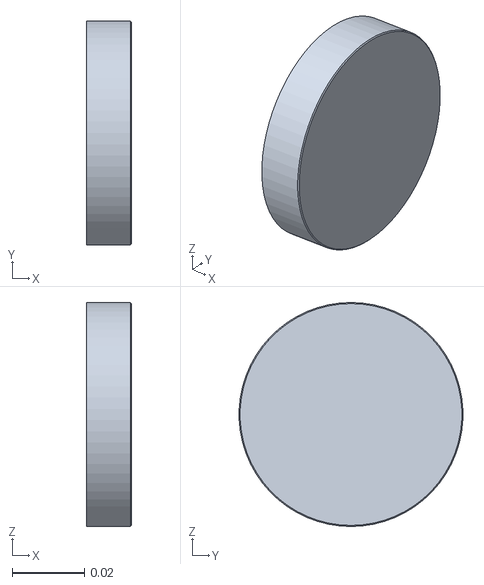
[picture p71: CAD file, 2023-12-11, last stored version]
ros2_ws/src/assets/robots/fanuc/fanuc_description/meshes/collision/link_6.stl
0.0125 x 0.0619 x 0.062
