stebenpe/MobileManipulator/ros2_ws/src/assets/robots/fanuc/fanuc_description/meshes/visual/base_link.stl

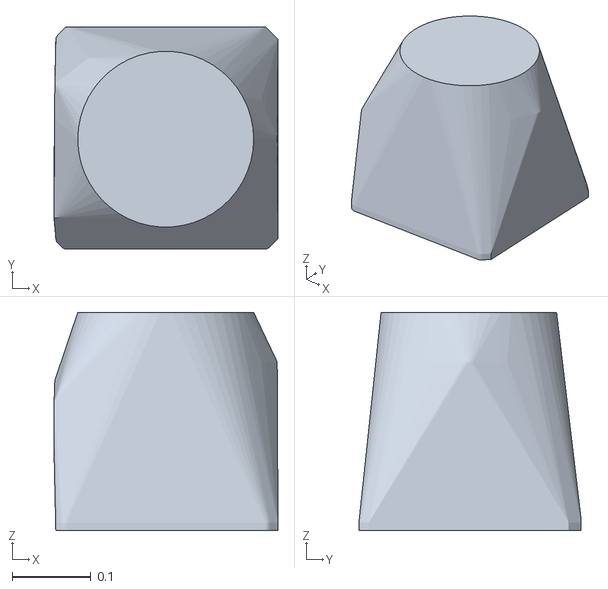
[picture p72: CAD file, 2023-12-11, last stored version]
ros2_ws/src/assets/robots/fanuc/fanuc_description/meshes/visual/base_link.stl
0.285 x 0.283 x 0.278
