stebenpe/MobileManipulator/ros2_ws/src/assets/robots/panda_robot/panda_description/meshes/collision/hand.stl

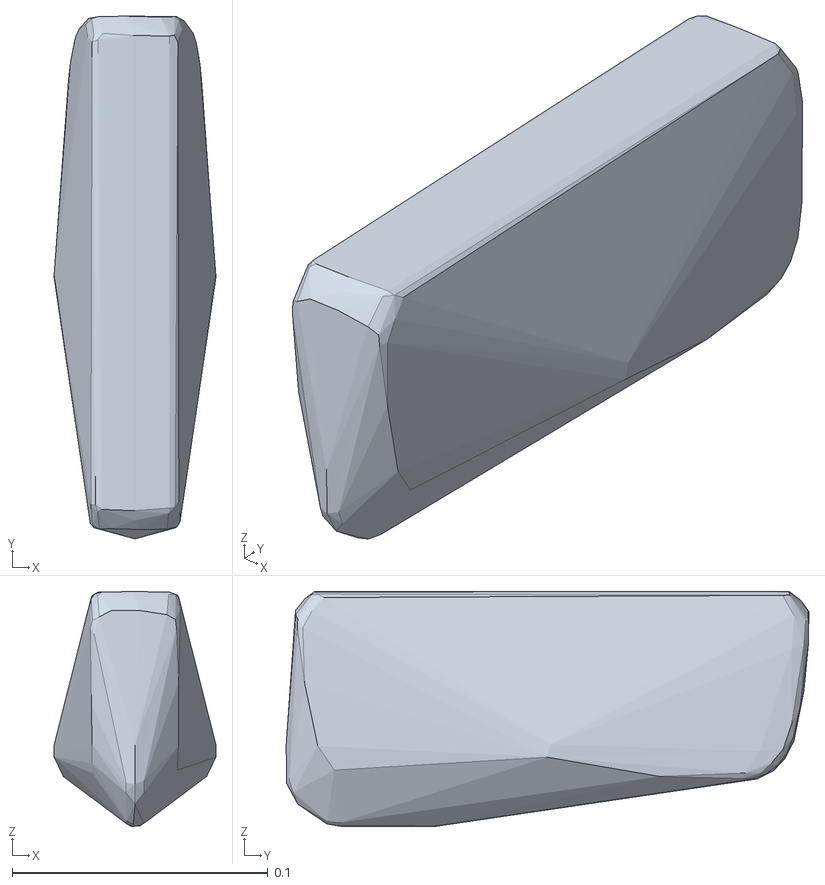
[picture p73: CAD file, 2023-12-11, last stored version]
ros2_ws/src/assets/robots/panda_robot/panda_description/meshes/collision/hand.stl
0.0633 x 0.204 x 0.0919
