stebenpe/MobileManipulator/ros2_ws/src/assets/robots/universal_robot/ur_description/meshes/ur10/collision/forearm.stl

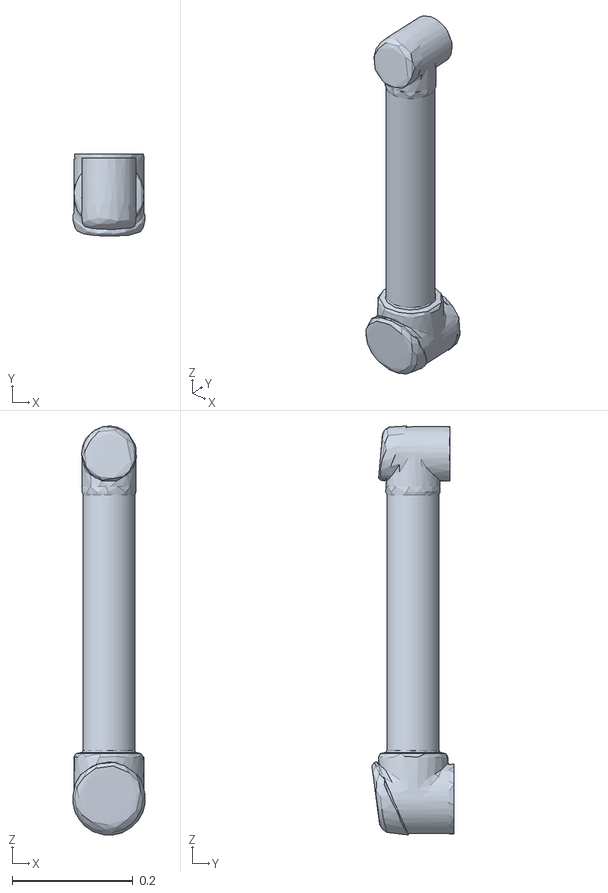
[picture p74: CAD file, 2023-12-11, last stored version]
ros2_ws/src/assets/robots/universal_robot/ur_description/meshes/ur10/collision/forearm.stl
0.12 x 0.136 x 0.678
