stebenpe/MobileManipulator/ros2_ws/src/assets/robots/universal_robot/ur_description/meshes/ur3/collision/upperarm.stl

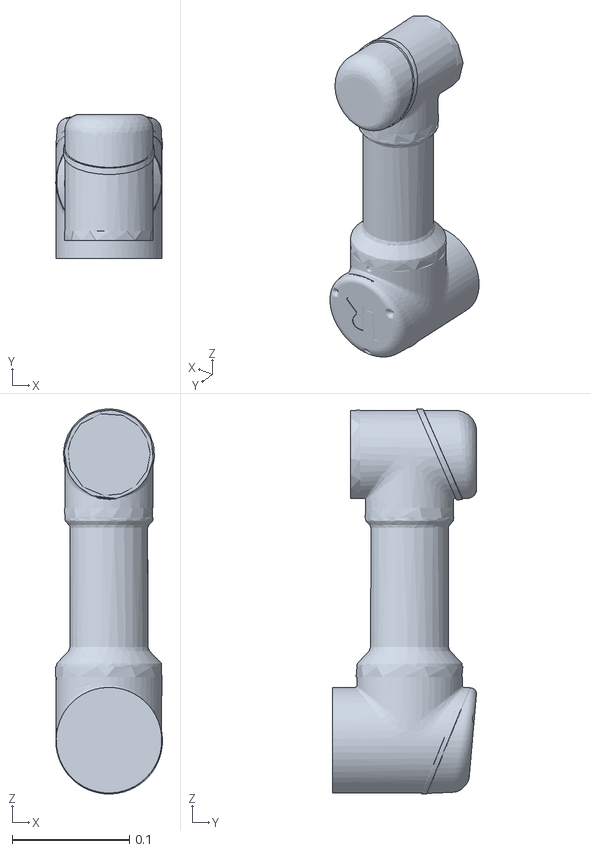
[picture p75: CAD file, 2023-12-11, last stored version]
ros2_ws/src/assets/robots/universal_robot/ur_description/meshes/ur3/collision/upperarm.stl
0.0912 x 0.123 x 0.328
