stebenpe/MobileManipulator/ros2_ws/src/assets/robots/universal_robot/ur_description/meshes/ur5/collision/upperarm.stl

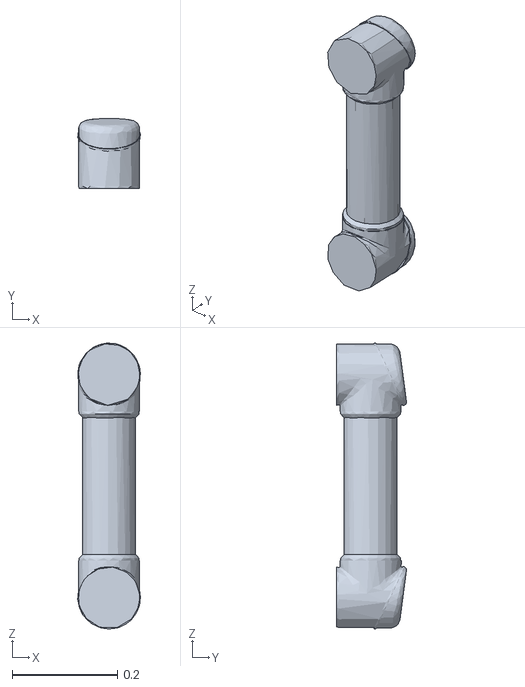
[picture p76: CAD file, 2023-12-11, last stored version]
ros2_ws/src/assets/robots/universal_robot/ur_description/meshes/ur5/collision/upperarm.stl
0.119 x 0.134 x 0.545
