stebenpe/MobileManipulator/ros2_ws/src/omron_moma/robot_description/meshes/tm5-900/collision/tm5_base_c.stl

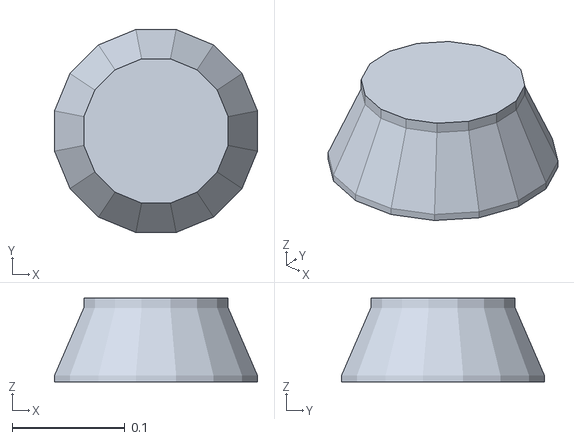
[picture p77: CAD file, 2023-12-11, last stored version]
ros2_ws/src/omron_moma/robot_description/meshes/tm5-900/collision/tm5_base_c.stl
0.18 x 0.18 x 0.0741
