stebenpe/MobileManipulator/ros2_ws/src/TM5/src/tm_models/meshes/tm12_1300/collision/tm_750w_01_c.STL

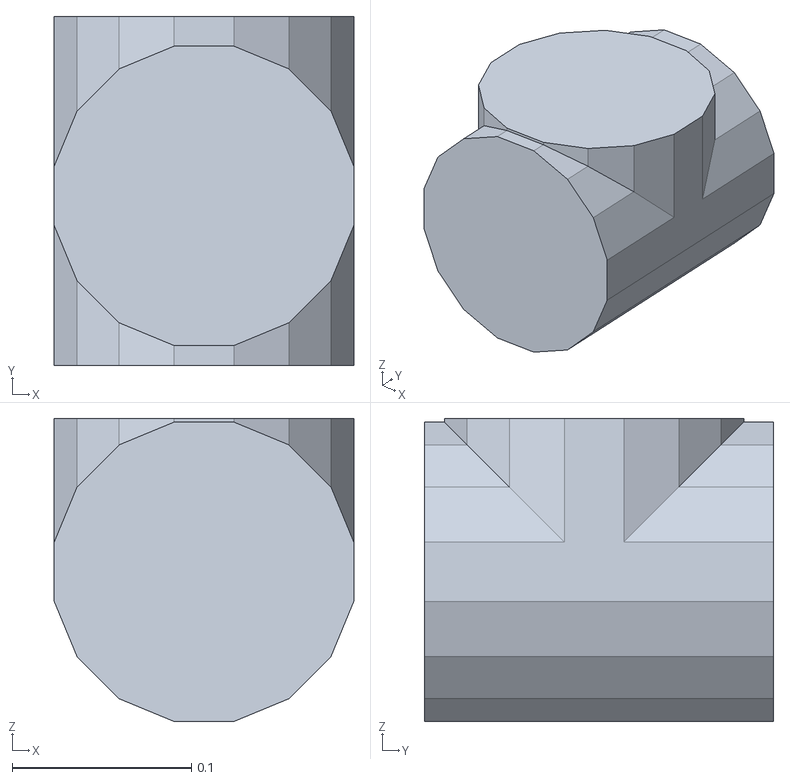
[picture p78: CAD file, 2023-12-11, last stored version]
ros2_ws/src/TM5/src/tm_models/meshes/tm12_1300/collision/tm_750w_01_c.STL
0.167 x 0.195 x 0.169
