stebenpe/MobileManipulator/ros2_ws/src/TM5/src/tm_models/meshes/tm12_1300/visual/tm_100w_01.stl

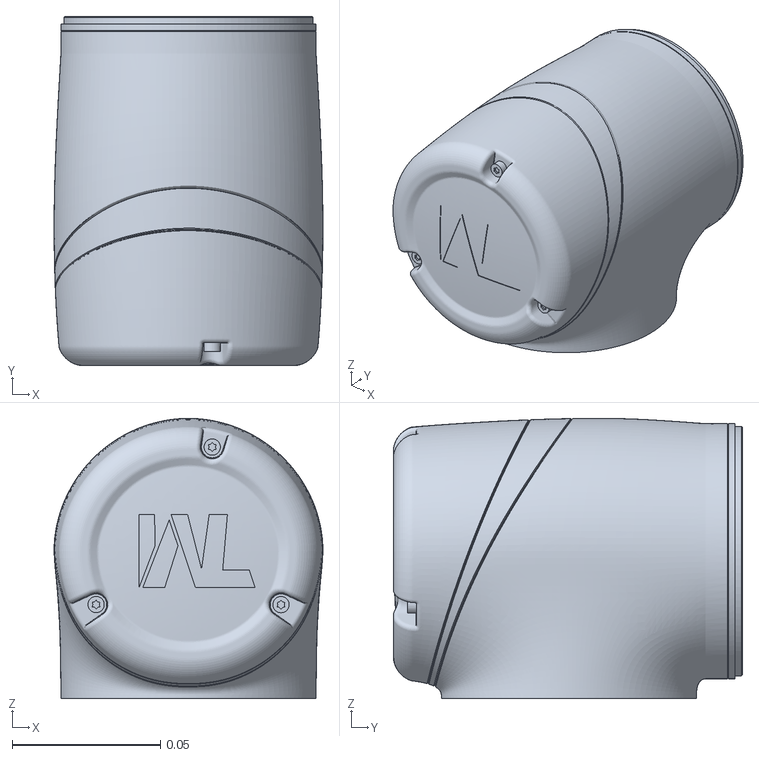
[picture p79: CAD file, 2023-12-11, last stored version]
ros2_ws/src/TM5/src/tm_models/meshes/tm12_1300/visual/tm_100w_01.stl
0.0906 x 0.118 x 0.0945
