stebenpe/MobileManipulator/ros2_ws/src/TM5/src/tmr_description/meshes/tm5-900/visual/tmr_ee.stl

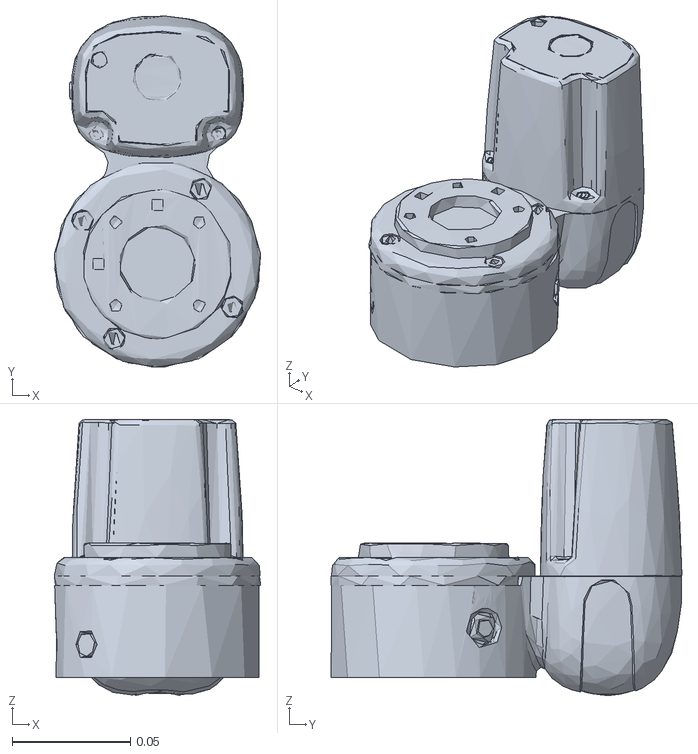
[picture p80: CAD file, 2023-12-11, last stored version]
ros2_ws/src/TM5/src/tmr_description/meshes/tm5-900/visual/tmr_ee.stl
0.0874 x 0.149 x 0.117
