stebenpe/MobileManipulator/ros2_ws/src/ZED/src/zed-ros2-wrapper/zed-ros2-interfaces/meshes/zedm.stl

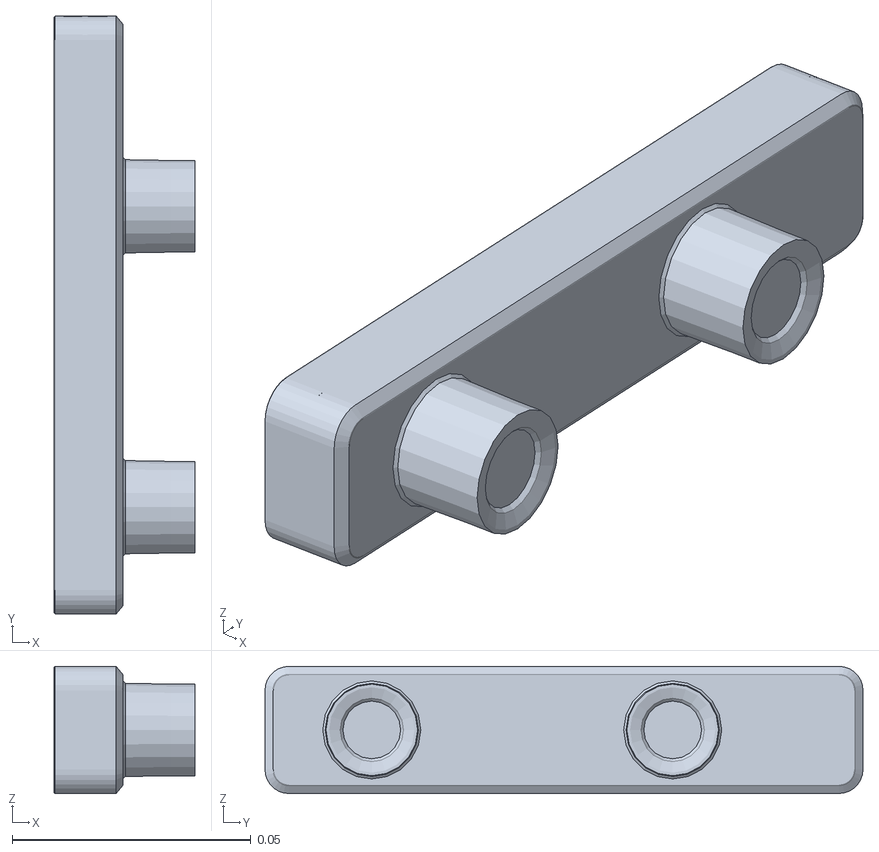
[picture p81: CAD file, 2023-12-11, last stored version]
ros2_ws/src/ZED/src/zed-ros2-wrapper/zed-ros2-interfaces/meshes/zedm.stl
0.0295 x 0.125 x 0.0266
