stebenpe/MobileManipulator/maak onderdelen/3D prints/2X kabel beugel 2.STL

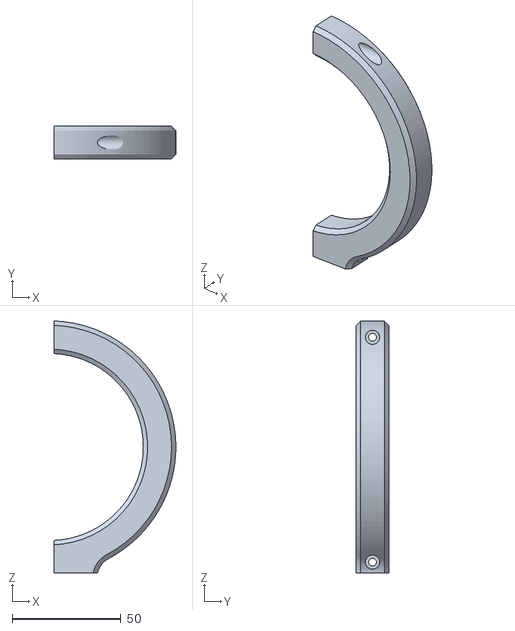
[picture p82: CAD file, 2023-12-11, last stored version]
maak onderdelen/3D prints/2X kabel beugel 2.STL
56.0 x 15.0 x 115.9
