stebenpe/MobileManipulator/ros2_ws/src/assets/robots/panda_robot/panda_description/meshes/collision/finger.stl

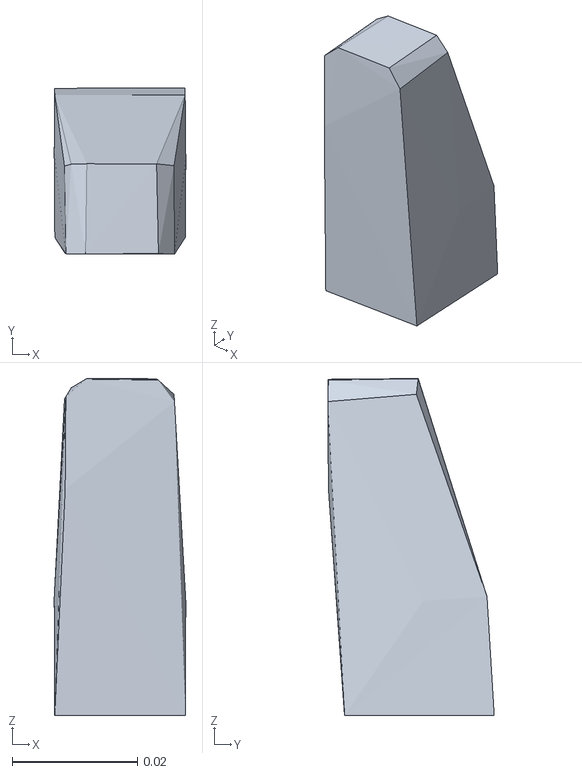
[picture p86: CAD file, 2023-12-11, last stored version]
ros2_ws/src/assets/robots/panda_robot/panda_description/meshes/collision/finger.stl
0.021 x 0.0265 x 0.0537
