stebenpe/MobileManipulator/ros2_ws/src/assets/robots/universal_robot/ur_description/meshes/ur3/collision/forearm.stl

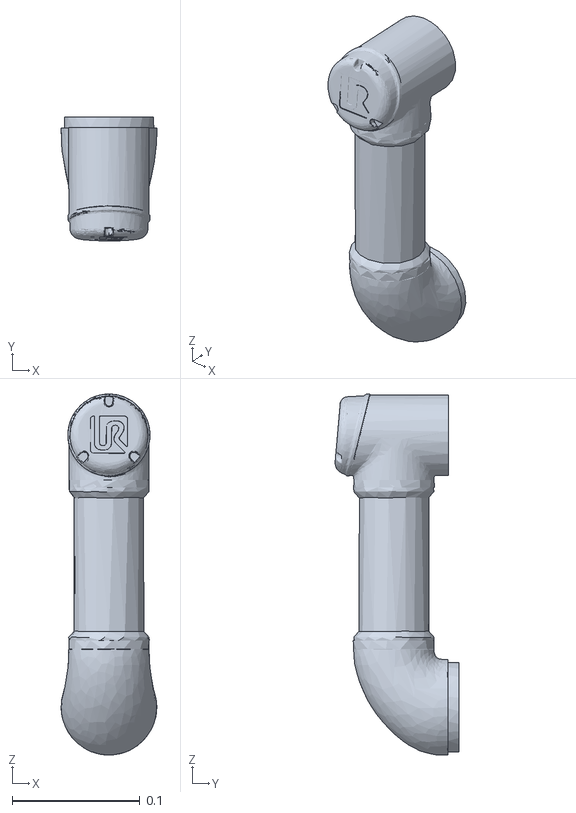
[picture p88: CAD file, 2023-12-11, last stored version]
ros2_ws/src/assets/robots/universal_robot/ur_description/meshes/ur3/collision/forearm.stl
0.0751 x 0.0971 x 0.283
