stebenpe/MobileManipulator/ros2_ws/src/assets/robots/universal_robot/ur_description/meshes/ur5/collision/forearm.stl

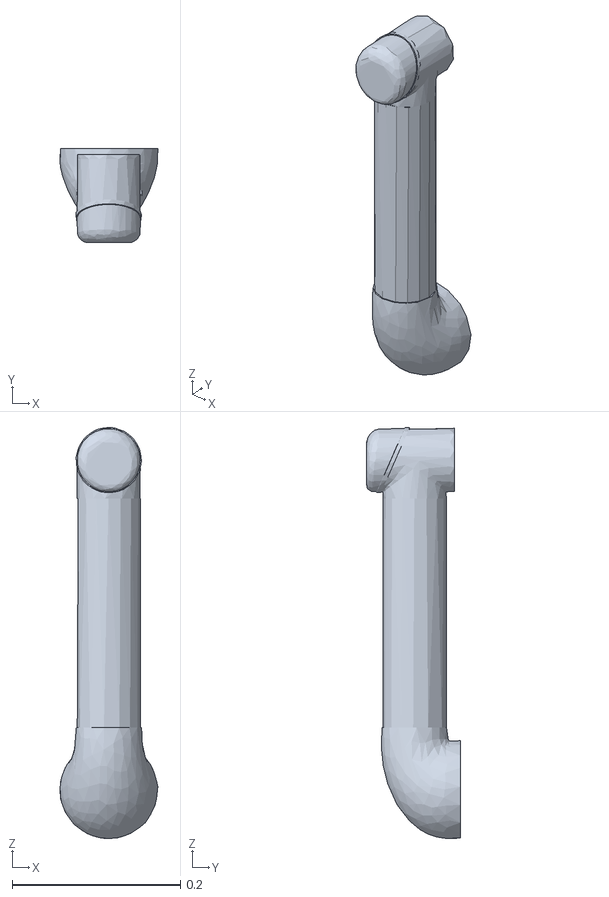
[picture p89: CAD file, 2023-12-11, last stored version]
ros2_ws/src/assets/robots/universal_robot/ur_description/meshes/ur5/collision/forearm.stl
0.116 x 0.112 x 0.489
