stebenpe/MobileManipulator/ros2_ws/src/TM5/src/tm_models/meshes/tm12_1300/collision/tm_100w_01_c.STL

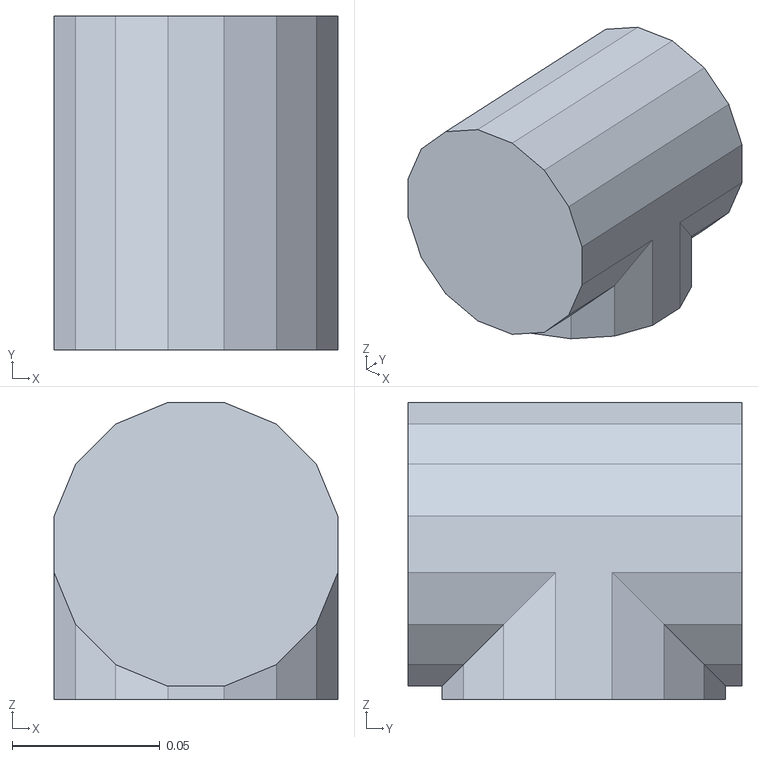
[picture p90: CAD file, 2023-12-11, last stored version]
ros2_ws/src/TM5/src/tm_models/meshes/tm12_1300/collision/tm_100w_01_c.STL
0.096 x 0.113 x 0.1
