stebenpe/MobileManipulator/ros2_ws/src/TM5/src/tm_models/meshes/tm5_900/visual/tm_400w_01.stl

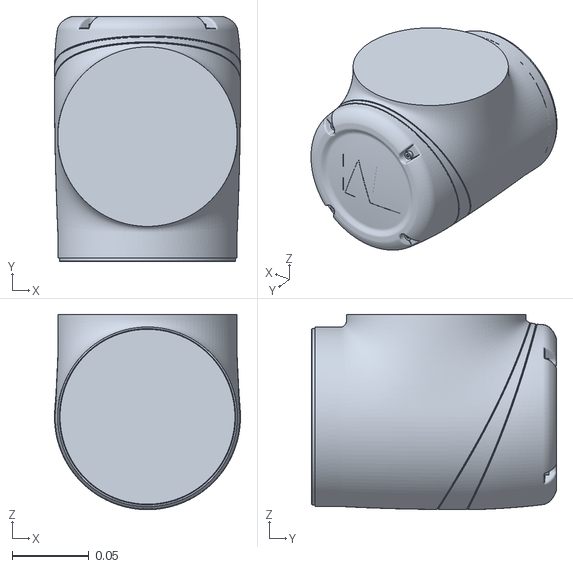
[picture p91: CAD file, 2023-12-11, last stored version]
ros2_ws/src/TM5/src/tm_models/meshes/tm5_900/visual/tm_400w_01.stl
0.121 x 0.16 x 0.127
