stebenpe/MobileManipulator/ros2_ws/src/ZED/src/zed-ros2-wrapper/zed-ros2-interfaces/meshes/zed2i.stl

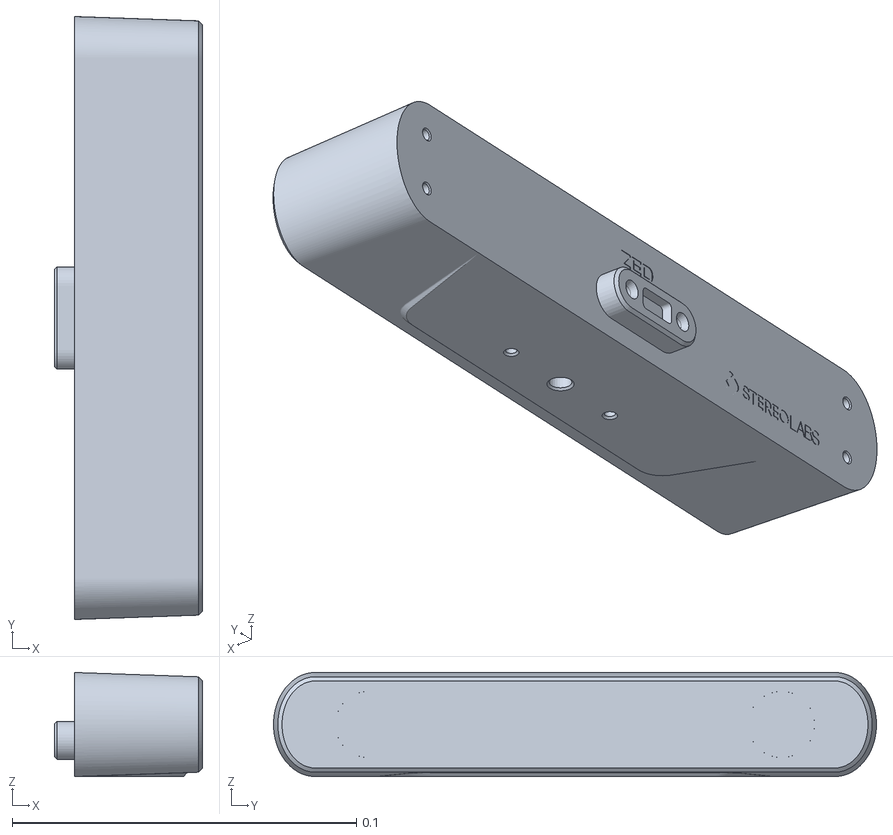
[picture p92: CAD file, 2023-12-11, last stored version]
ros2_ws/src/ZED/src/zed-ros2-wrapper/zed-ros2-interfaces/meshes/zed2i.stl
0.0431 x 0.175 x 0.0303
