stebenpe/MobileManipulator/maak onderdelen/3D prints/3D-print-jetson-holder-boven.STL

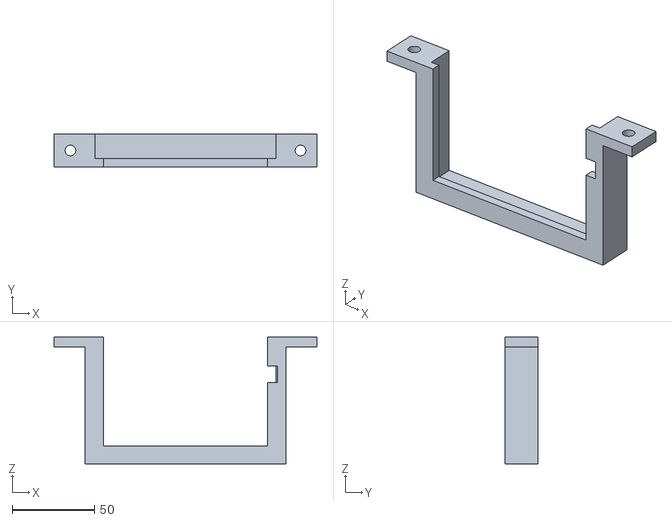
[picture p93: CAD file, 2023-12-11, last stored version]
maak onderdelen/3D prints/3D-print-jetson-holder-boven.STL
160.0 x 20.0 x 77.1
