stebenpe/MobileManipulator/maak onderdelen/watersnijden/tussen plaat 2X 3mm.DXF

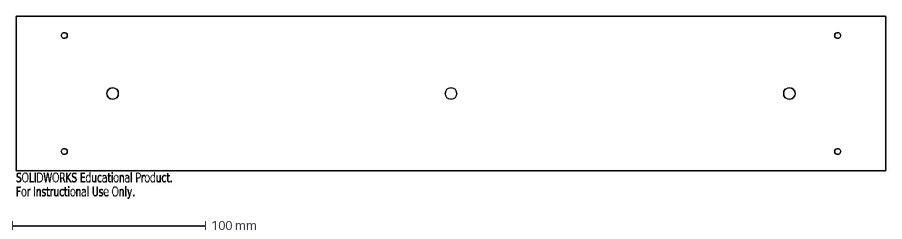
[picture p94: CAD file, 2023-12-11, last stored version]
maak onderdelen/watersnijden/tussen plaat 2X 3mm.DXF
SOLIDWORKS Educational Product.
For Instructional Use Only.
