stebenpe/MobileManipulator/ros2_ws/src/assets/end_effectors/robotiq_85_gripper/robotiq_85_description/meshes/collision/kinova_robotiq_coupler.stl

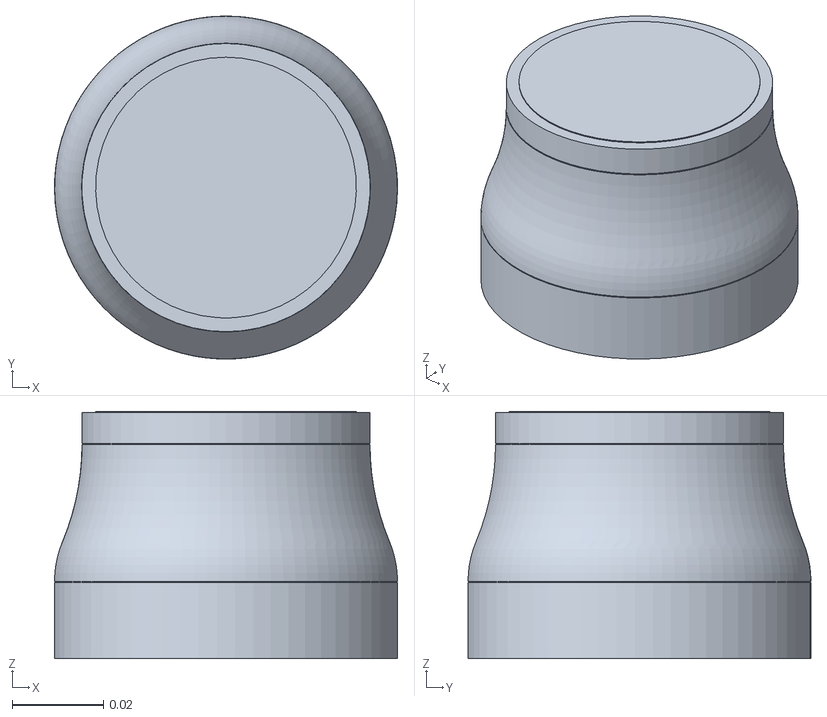
[picture p97: CAD file, 2023-12-11, last stored version]
ros2_ws/src/assets/end_effectors/robotiq_85_gripper/robotiq_85_description/meshes/collision/kinova_robotiq_coupler.stl
0.075 x 0.075 x 0.054
