stebenpe/MobileManipulator/ros2_ws/src/assets/robots/fanuc/fanuc_description/meshes/collision/link_4.stl

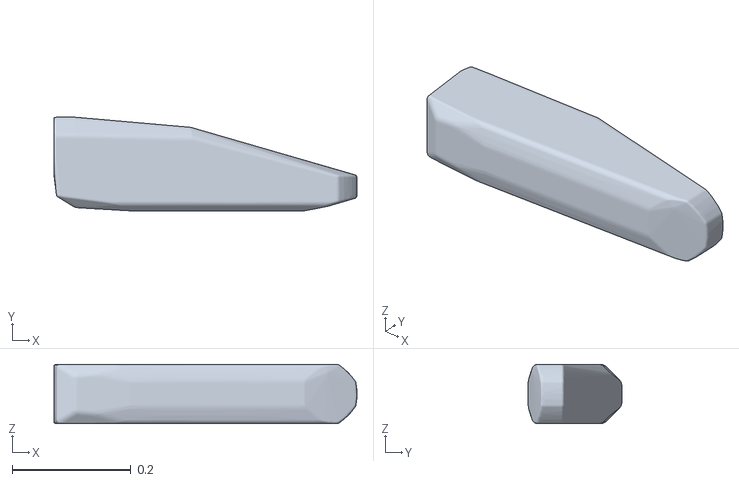
[picture p98: CAD file, 2023-12-11, last stored version]
ros2_ws/src/assets/robots/fanuc/fanuc_description/meshes/collision/link_4.stl
0.511 x 0.158 x 0.1
