stebenpe/MobileManipulator/ros2_ws/src/assets/robots/universal_robot/ur_description/meshes/ur10/collision/wrist3.stl

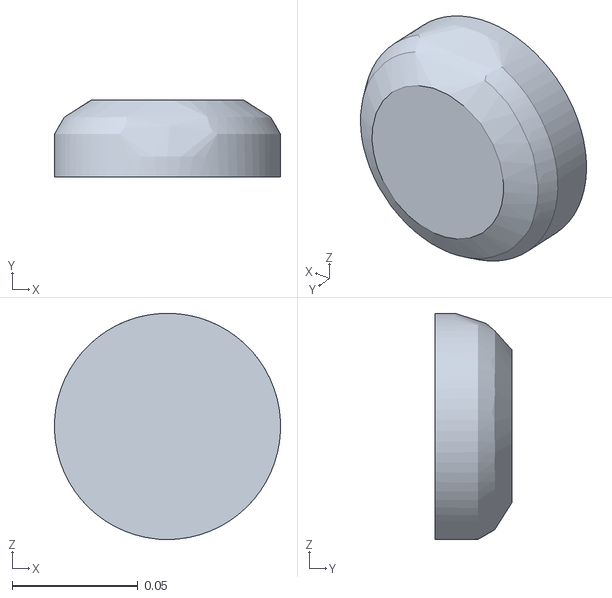
[picture p99: CAD file, 2023-12-11, last stored version]
ros2_ws/src/assets/robots/universal_robot/ur_description/meshes/ur10/collision/wrist3.stl
0.0899 x 0.0305 x 0.0901
