stebenpe/MobileManipulator/ros2_ws/src/assets/robots/universal_robot/ur_description/meshes/ur5/collision/wrist2.stl

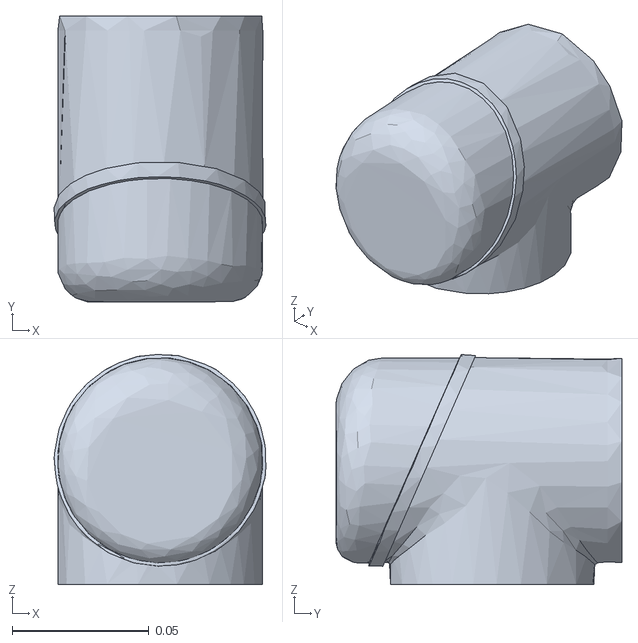
[picture p100: CAD file, 2023-12-11, last stored version]
ros2_ws/src/assets/robots/universal_robot/ur_description/meshes/ur5/collision/wrist2.stl
0.0776 x 0.105 x 0.0842
