stebenpe/MobileManipulator/ros2_ws/src/omron_moma/robot_description/meshes/tm5-900/visual/tm5-900_arm1.stl

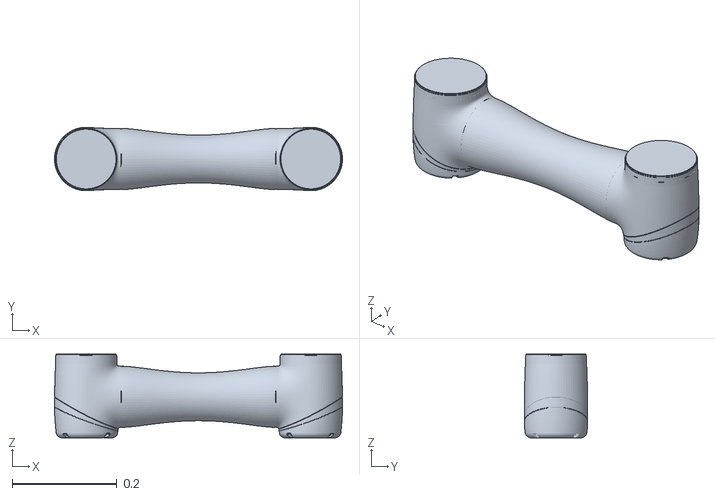
[picture p101: CAD file, 2023-12-11, last stored version]
ros2_ws/src/omron_moma/robot_description/meshes/tm5-900/visual/tm5-900_arm1.stl
0.55 x 0.121 x 0.16
