stebenpe/MobileManipulator/maak onderdelen/watersnijden/achterplaat elektra 2mm.DXF

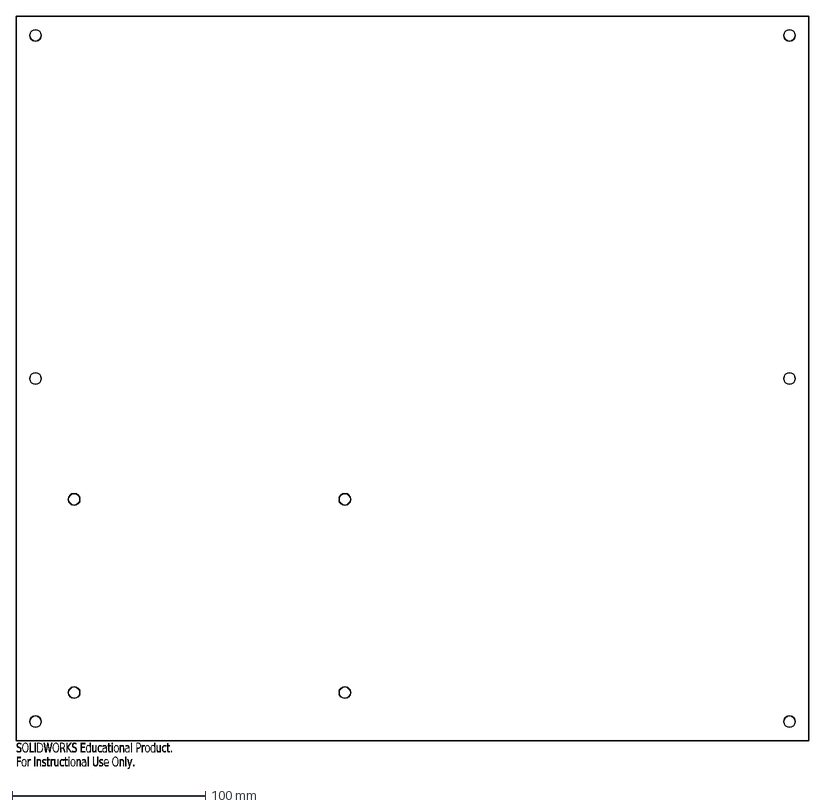
[picture p102: CAD file, 2023-12-11, last stored version]
maak onderdelen/watersnijden/achterplaat elektra 2mm.DXF
SOLIDWORKS Educational Product.
For Instructional Use Only.
