stebenpe/MobileManipulator/ros2_ws/src/assets/robots/panda_robot/panda_description/meshes/collision/link7.stl

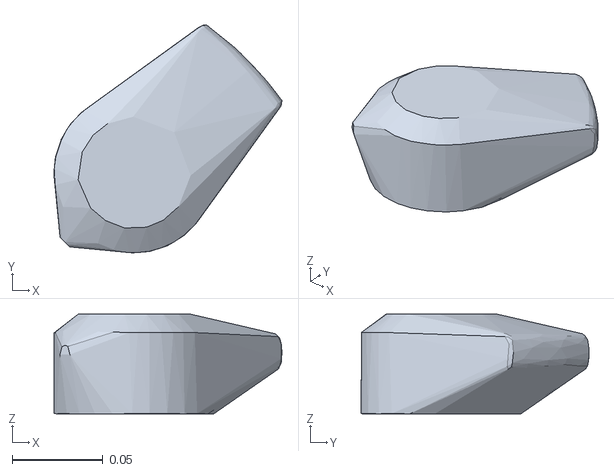
[picture p104: CAD file, 2023-12-11, last stored version]
ros2_ws/src/assets/robots/panda_robot/panda_description/meshes/collision/link7.stl
0.125 x 0.125 x 0.0548
