stebenpe/MobileManipulator/ros2_ws/src/assets/robots/universal_robot/ur_description/meshes/ur3/collision/wrist3.stl

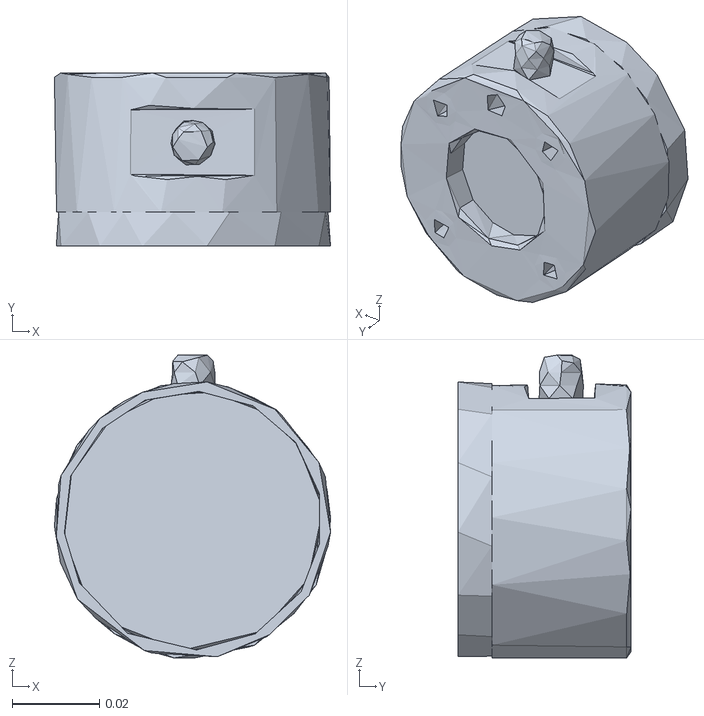
[picture p106: CAD file, 2023-12-11, last stored version]
ros2_ws/src/assets/robots/universal_robot/ur_description/meshes/ur3/collision/wrist3.stl
0.0635 x 0.0398 x 0.0696
