stebenpe/MobileManipulator/ros2_ws/src/TM5/src/tm_models/meshes/tm12_1300/visual/tm12_base.stl

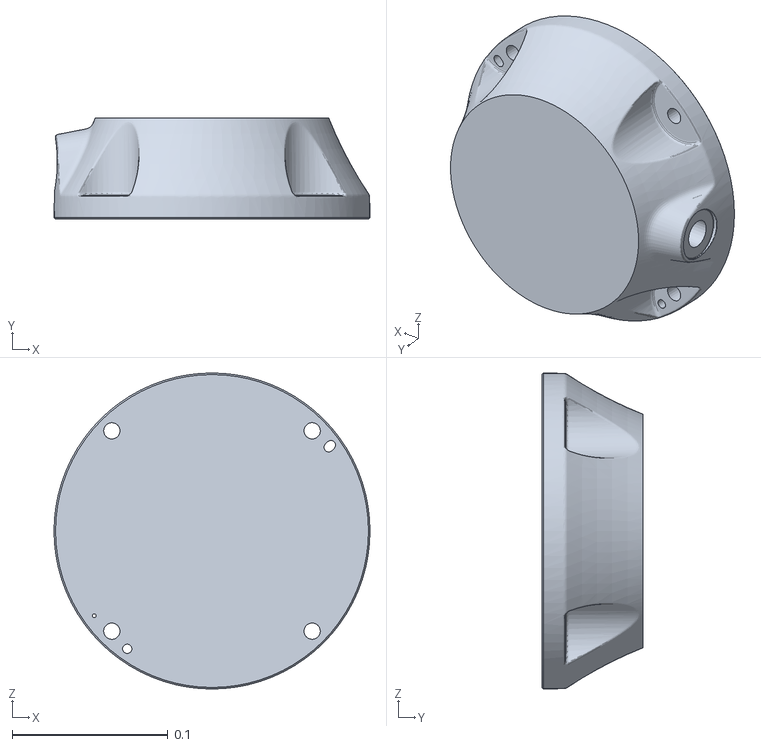
[picture p108: CAD file, 2023-12-11, last stored version]
ros2_ws/src/TM5/src/tm_models/meshes/tm12_1300/visual/tm12_base.stl
0.203 x 0.065 x 0.203
