stebenpe/MobileManipulator/maak onderdelen/3D prints/2X kabel beugel groot2.STL

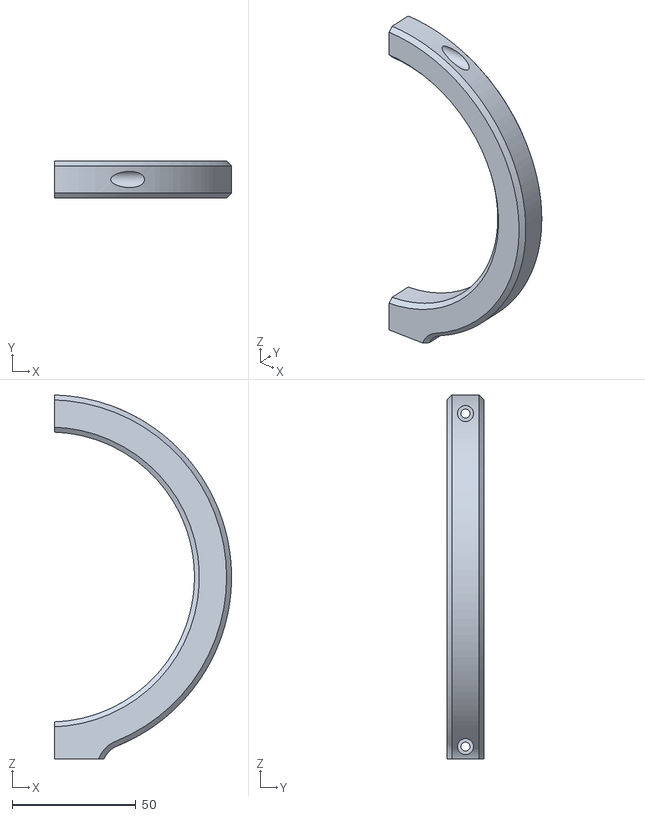
[picture p109: CAD file, 2023-12-11, last stored version]
maak onderdelen/3D prints/2X kabel beugel groot2.STL
71.5 x 15.0 x 146.9
