stebenpe/MobileManipulator/maak onderdelen/watersnijden/top plate ld90 3mm.DXF

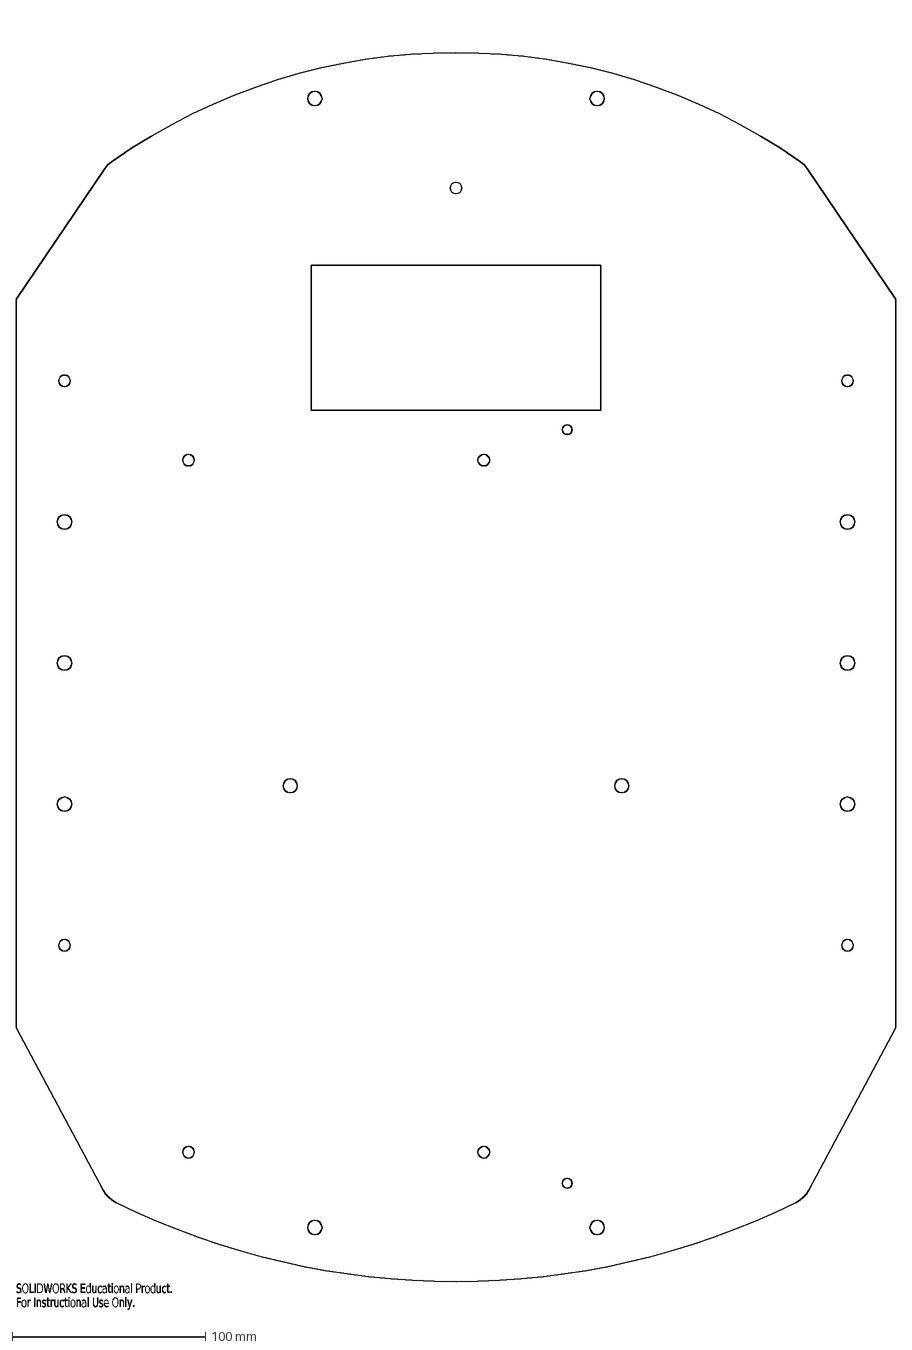
[picture p110: CAD file, 2023-12-11, last stored version]
maak onderdelen/watersnijden/top plate ld90 3mm.DXF
SOLIDWORKS Educational Product.
For Instructional Use Only.
