stebenpe/MobileManipulator/ros2_ws/src/assets/robots/fanuc/fanuc_description/meshes/collision/link_3.stl

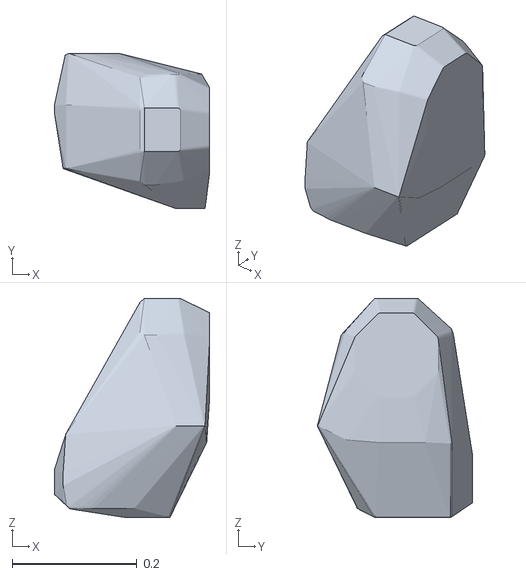
[picture p111: CAD file, 2023-12-11, last stored version]
ros2_ws/src/assets/robots/fanuc/fanuc_description/meshes/collision/link_3.stl
0.25 x 0.25 x 0.352
