stebenpe/MobileManipulator/ros2_ws/src/TM5/src/tm_models/meshes/tm12_1300/collision/tm12_base_c.STL

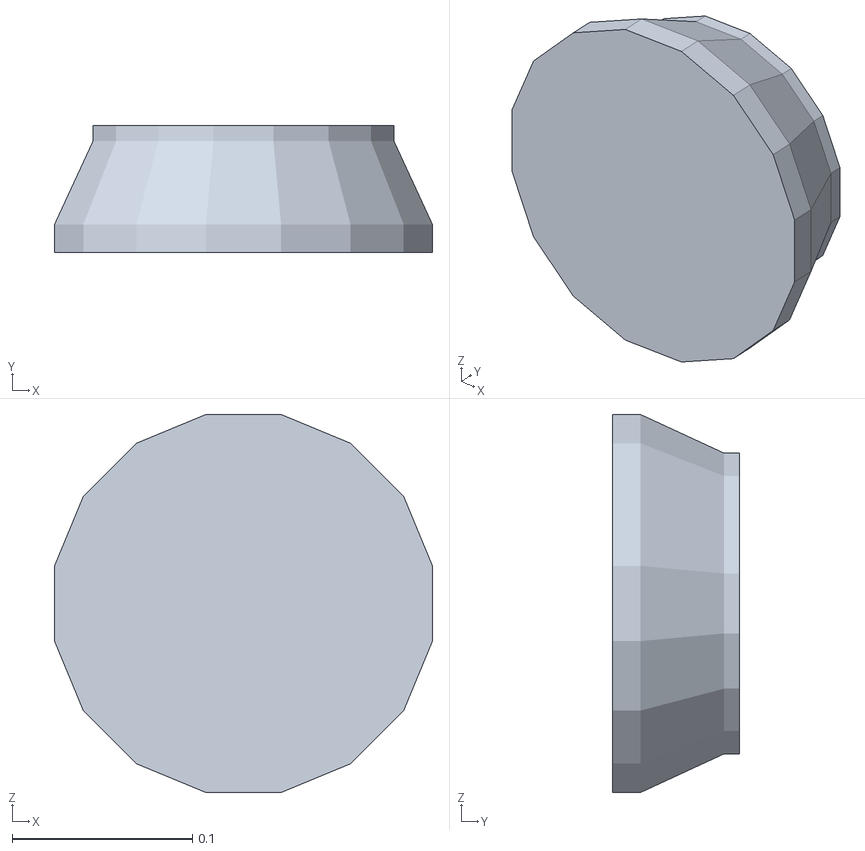
[picture p115: CAD file, 2023-12-11, last stored version]
ros2_ws/src/TM5/src/tm_models/meshes/tm12_1300/collision/tm12_base_c.STL
0.21 x 0.0706 x 0.21
