stebenpe/MobileManipulator/ros2_ws/src/TM5/src/tm_models/meshes/tm12_1300/visual/tm12_arm1.stl

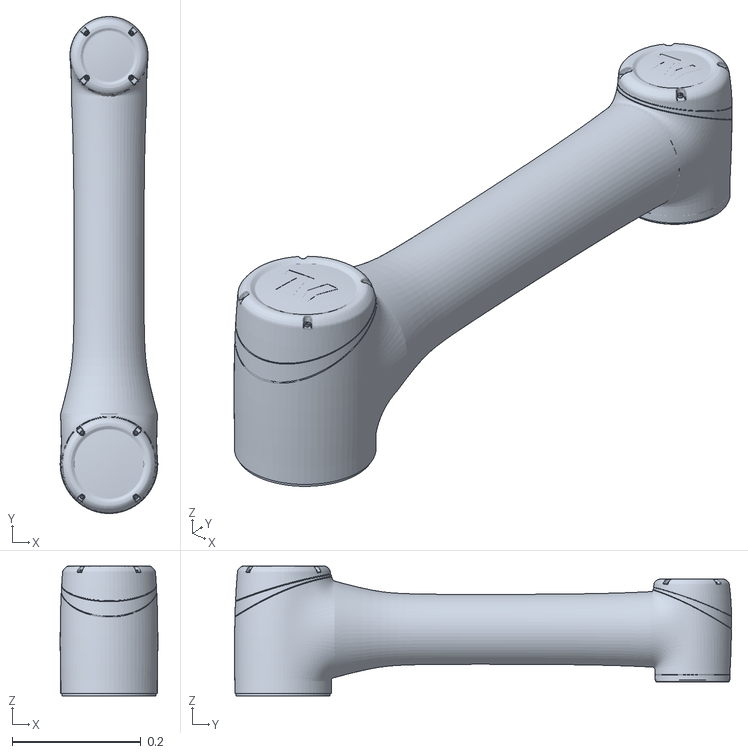
[picture p116: CAD file, 2023-12-11, last stored version]
ros2_ws/src/TM5/src/tm_models/meshes/tm12_1300/visual/tm12_arm1.stl
0.152 x 0.772 x 0.202
