stebenpe/MobileManipulator/maak onderdelen/3D prints/2X kabel beugel groot1.STL

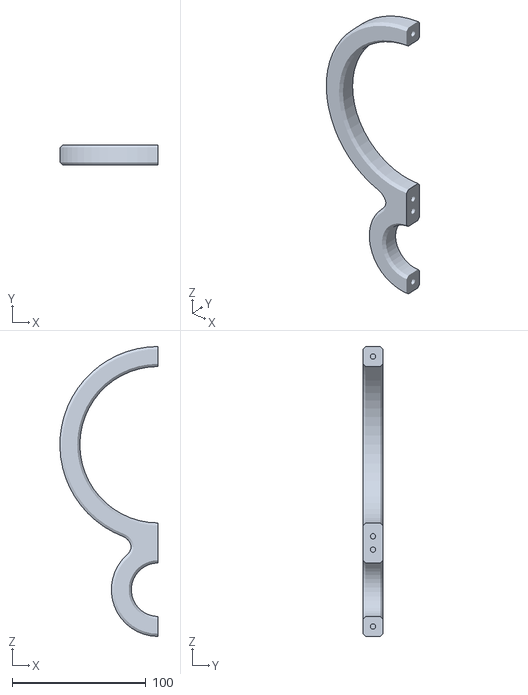
[picture p117: CAD file, 2023-12-11, last stored version]
maak onderdelen/3D prints/2X kabel beugel groot1.STL
73.5 x 15.0 x 217.0
