stebenpe/MobileManipulator/maak onderdelen/watersnijden/Flat pattern - voor plaat sheet metal 2mm.DXF

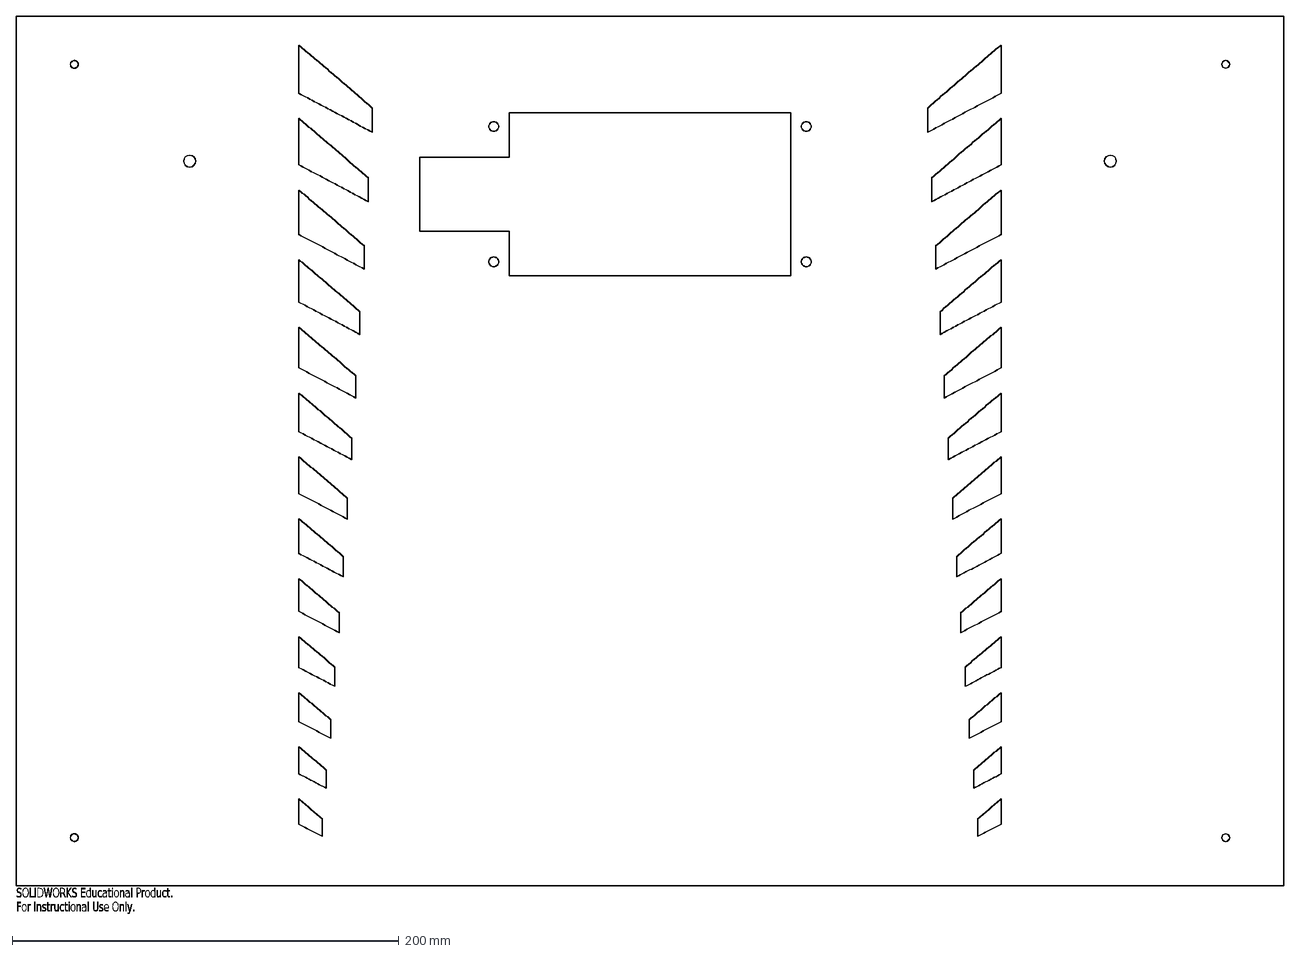
[picture p118: CAD file, 2023-12-11, last stored version]
maak onderdelen/watersnijden/Flat pattern - voor plaat sheet metal 2mm.DXF
SOLIDWORKS Educational Product.
For Instructional Use Only.
