stebenpe/MobileManipulator/(list of files, cad)

Other CAD files:
ros2_ws/src/TM5/src/tm_models/meshes/tm12_1300/collision/tm_100w_02_c.STL
ros2_ws/src/TM5/src/tmr_description/meshes/gripper/robotiq/2f-85/robotiq_85_gripper.stl
maak onderdelen/3D prints/sensor blok L V1.2.STL
ros2_ws/src/assets/end_effectors/robotiq_3f_gripper/robotiq_3f_gripper_description/meshes/robotiq-3f-gripper/visual/GRIPPER_OPEN_FINGER_2.stl
ros2_ws/src/omron_moma/robot_description/meshes/tm5-900/visual/tm5_base.stl
ros2_ws/src/TM5/src/tmr_description/meshes/tm5-900/collision/tm5-900_arm2_c.stl
ros2_ws/src/assets/end_effectors/robotiq_3f_gripper/robotiq_3f_gripper_description/meshes/robotiq-3f-gripper/collision/GRIPPER_OPEN_FINGER_2.stl
ros2_ws/src/TM5/src/tm_models/meshes/tm5_900/collision/tm5_900_arm1_c.STL
ros2_ws/src/TM5/src/tm_models/meshes/tm5_900/visual/tm_100w_02.stl
ros2_ws/src/TM5/src/tmr_description/meshes/tm5-900/collision/tmr_400w_01_c.stl
ros2_ws/src/omron_moma/robot_description/meshes/tm5-900/visual/tmr_100w_02.stl
ros2_ws/src/TM5/src/tm_models/meshes/tm5_900/collision/tm_100w_02_c.STL
ros2_ws/src/TM5/src/tmr_description/meshes/tm5-900/visual/tm5_base.stl
ros2_ws/src/assets/end_effectors/robotiq_3f_gripper/robotiq_3f_gripper_description/meshes/robotiq-3f-gripper/collision/GRIPPER_OPEN_FINGER_3.stl
ros2_ws/src/assets/robots/panda_robot/panda_description/meshes/collision/link2.stl
ros2_ws/src/assets/robots/universal_robot/ur_description/meshes/ur3/collision/wrist1.stl
ros2_ws/src/omron_moma/robot_description/meshes/tm5-900/collision/tm5-900_arm2_c.stl
ros2_ws/src/TM5/src/tm_models/meshes/tm12_1300/visual/tm_100w_02.stl
ros2_ws/src/TM5/src/tm_models/meshes/tm5_900/visual/tm5_900_arm1.stl
ros2_ws/src/TM5/src/tmr_description/meshes/tm5-900/visual/tmr_100w_01.stl
maak onderdelen/3D prints/3D-print-jetson-holder-onder.STL
ros2_ws/src/assets/end_effectors/robotiq_3f_gripper/robotiq_3f_gripper_description/meshes/robotiq-3f-gripper/visual/GRIPPER_OPEN_FINGER_3.stl
ros2_ws/src/omron_moma/robot_description/meshes/tm5-900/collision/tmr_100w_01_c.stl
ros2_ws/src/TM5/src/tmr_description/meshes/tm5-900/visual/tm5-900_arm1.stl
ros2_ws/src/assets/robots/universal_robot/ur_description/meshes/ur10/collision/wrist1.stl
ros2_ws/src/omron_moma/robot_description/meshes/tm5-900/collision/tmr_400w_01_c.stl
ros2_ws/src/omron_moma/robot_description/meshes/tm5-900/visual/tmr_400w_01.stl
ros2_ws/src/TM5/src/tm_models/meshes/tm5_900/collision/tm5_base_c.STL
ros2_ws/src/TM5/src/tm_models/meshes/tm5_900/visual/tm5_900_arm2.stl
ros2_ws/src/TM5/src/tmr_description/meshes/tm5-900/collision/tmr_100w_01_c.stl
maak onderdelen/3D prints/2X kabel beugel 1.STL
maak onderdelen/3D prints/4X kabel beugel 3.STL
maak onderdelen/3D prints/4X tusssen blok controller en top plate.STL
maak onderdelen/3D prints/LD 90 panel 3d print.STL
maak onderdelen/watersnijden/3d camera holder 2mm.DXF
maak onderdelen/watersnijden/Flat pattern - achter plaat sheet metal 2mm.DXF
ros2_ws/src/TM5/src/tm_models/meshes/tm12_1300/collision/tm12_arm1_c.STL
ros2_ws/src/TM5/src/tm_models/meshes/tm12_1300/collision/tm_100w_02_c.stl
ros2_ws/src/TM5/src/tm_models/meshes/tm12_1300/visual/tm12_arm2.obj
ros2_ws/src/TM5/src/tm_models/meshes/tm12_1300/visual/tm12_base.obj
ros2_ws/src/TM5/src/tm_models/meshes/tm12_1300/visual/tm_100w_01.obj
ros2_ws/src/TM5/src/tm_models/meshes/tm12_1300/visual/tm_100w_02.obj
ros2_ws/src/TM5/src/tm_models/meshes/tm12_1300/visual/tm_750w_01.obj
ros2_ws/src/TM5/src/tm_models/meshes/tm5_700/visual/tm5_700_arm2.obj
ros2_ws/src/TM5/src/tm_models/meshes/tm5_900/collision/tm_100w_02_c.stl
ros2_ws/src/TM5/src/tm_models/meshes/tm5_900/visual/tm5_900_arm2.obj
ros2_ws/src/TM5/src/tm_models/meshes/tm5_900/visual/tm5_base.obj
ros2_ws/src/TM5/src/tm_models/meshes/tm5_900/visual/tm_100w_01.obj
ros2_ws/src/TM5/src/tm_models/meshes/tm5_900/visual/tm_100w_02.obj
ros2_ws/src/TM5/src/tm_models/meshes/tm5_900/visual/tm_400w_01.obj
ros2_ws/src/TM5/src/tmr_description/meshes/gripper/robotiq/2f-85/robotiq_85_gripper.obj
ros2_ws/src/TM5/src/tmr_description/meshes/tm5-900/visual/tm5-900_arm1.obj
ros2_ws/src/TM5/src/tmr_description/meshes/tm5-900/visual/tm5-900_arm2.obj
ros2_ws/src/TM5/src/tmr_description/meshes/tm5-900/visual/tm5_base.obj
ros2_ws/src/TM5/src/tmr_description/meshes/tm5-900/visual/tm5_base_old.obj
ros2_ws/src/TM5/src/tmr_description/meshes/tm5-900/visual/tmr_100w_01.obj
ros2_ws/src/TM5/src/tmr_description/meshes/tm5-900/visual/tmr_100w_02.obj
ros2_ws/src/TM5/src/tmr_description/meshes/tm5-900/visual/tmr_400w_01.obj
ros2_ws/src/TM5/src/tmr_description/meshes/tm5-900/visual/tmr_400w_01.stl
ros2_ws/src/TM5/src/tmr_description/meshes/tm5-900/visual/tmr_ee.obj
ros2_ws/src/assets/robots/panda_robot/panda_description/meshes/collision/link0.stl
ros2_ws/src/assets/robots/panda_robot/panda_description/meshes/collision/link4.stl
ros2_ws/src/assets/robots/panda_robot/panda_description/meshes/collision/link6.stl
ros2_ws/src/omron_moma/robot_description/meshes/chassis/chassis.obj
ros2_ws/src/omron_moma/robot_description/meshes/gripper/robotiq/2f-85/robotiq_85_gripper.obj
ros2_ws/src/omron_moma/robot_description/meshes/tm5-900/visual/tm5-900_arm2.obj
ros2_ws/src/omron_moma/robot_description/meshes/tm5-900/visual/tm5_base.obj
ros2_ws/src/omron_moma/robot_description/meshes/tm5-900/visual/tm5_base_old.obj
ros2_ws/src/omron_moma/robot_description/meshes/tm5-900/visual/tmr_100w_01.stl
