stebenpe/MobileManipulator/besturingskast/e-plan/EPLAN Mobile Manipulator 30-01-2024.pdf

Lights | 23456 B | 1 Safety | 23456789
14 C | 1 Bumper | 2345678 | D | 1 AUX power | 23456 E | 1 User power | 23456789

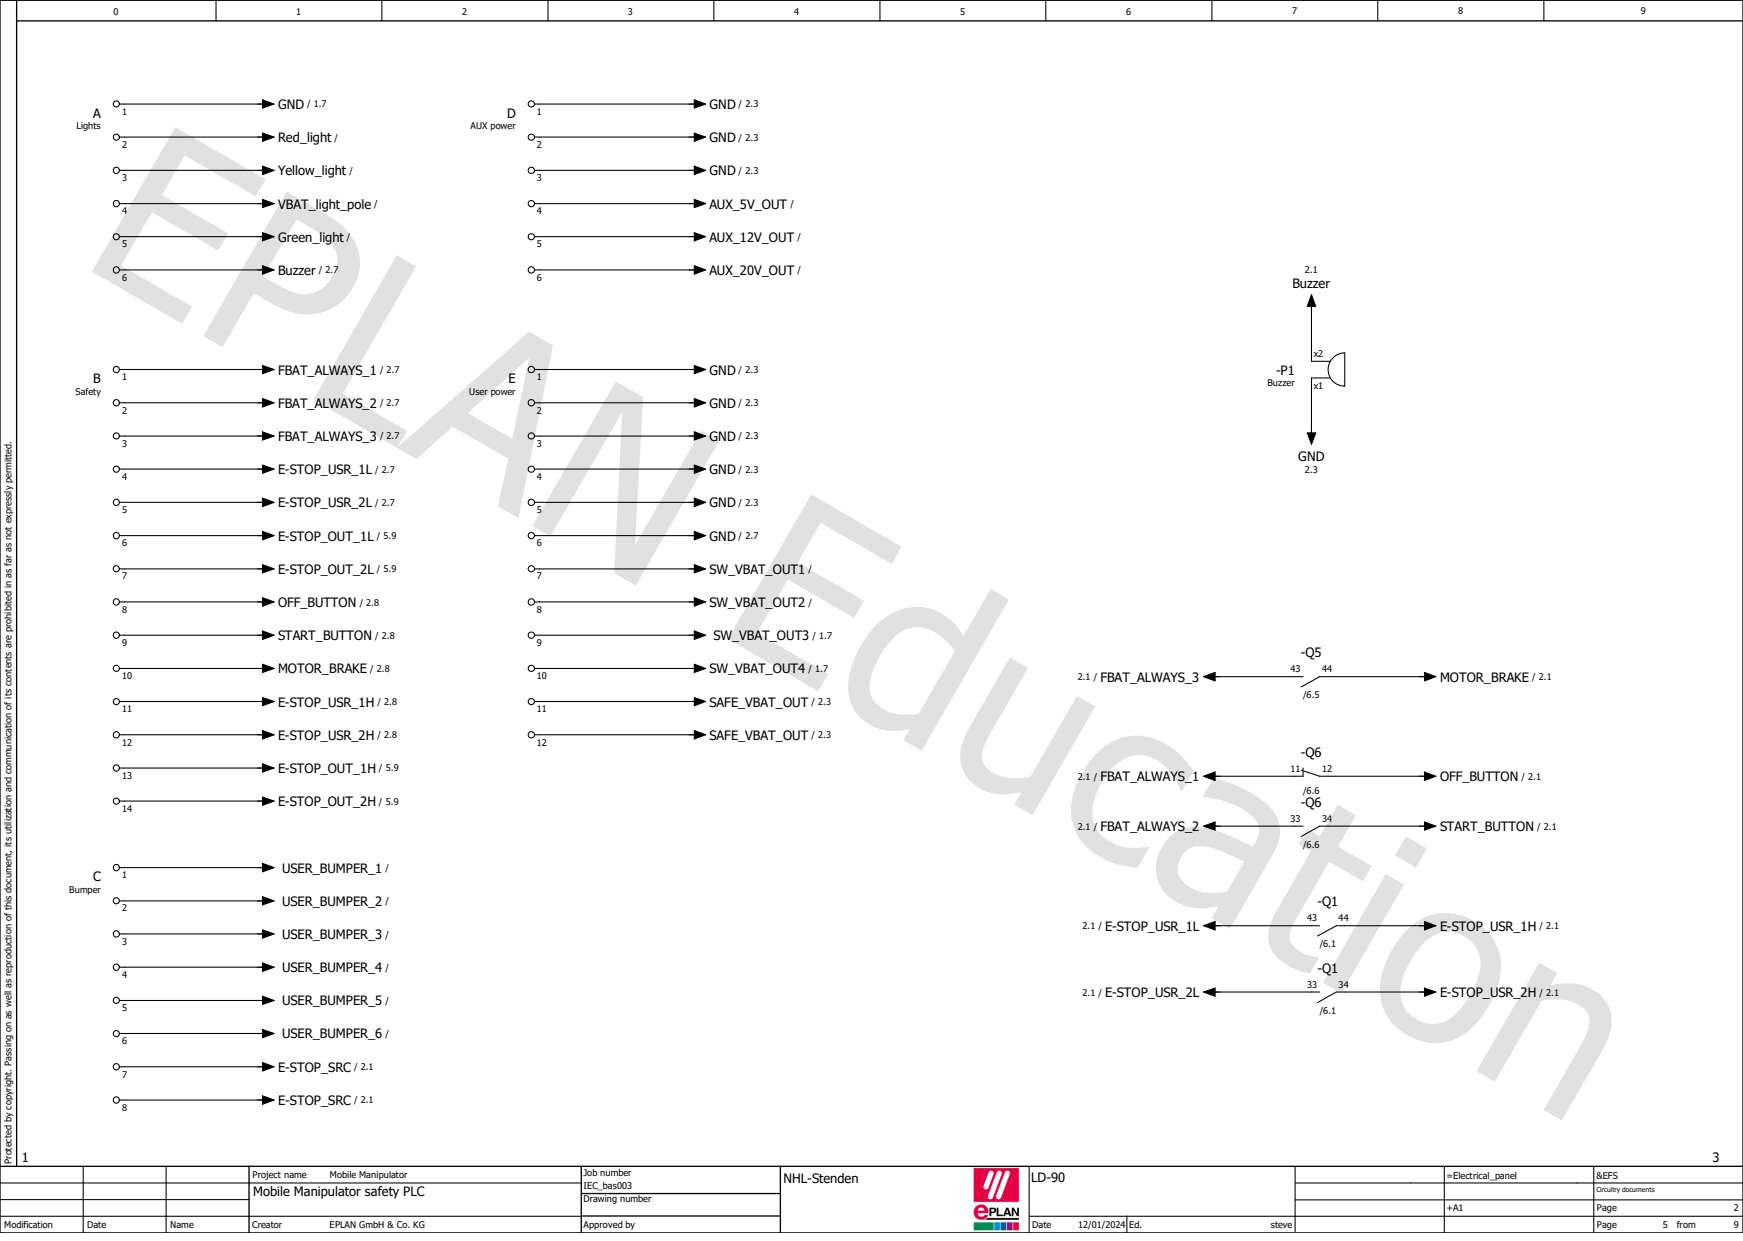
[picture p123: page 1]
IEC_bas003 Date; Date; steve 1; Modification; Name; NHL-Stenden; &EFS +A1 =Electrical_panel LD-90 ⁰; 2 Circuitry documents Page Mobile Manipulator; Approved by Project name; Drawing number Job number Creator; EPLAN GmbH & Co. KG Protected by copyright. Passing on as well as reproduction of this document, its utilization and communication of its contents are prohibited in as far as not expressly permitted.; -P1 Buzzer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

GND / 2.3 GND / 2.3 GND / 2.3 AUX_5V_OUT / AUX_12V_OUT / AUX_20V_OUT / GND / 2.3 GND / 2.3 GND / 2.3 GND / 2.3 GND / 2.3 GND / 2.7 SW_VBAT_OUT1 / SW_VBAT_OUT2 /

Mobile Manipulator safety PLC

Page from
