stebenpe/MobileManipulator/(commit log)

2023-12-11 b1 verslag update
    [2X kabel beugel 1.STL, 2X kabel beugel 2.STL, 2X kabel beugel groot1.STL, 2X kabel beugel groot2.STL, 2X side laser holder 2mm.DXF, 2X zei plaat 2mm.DXF, 3D-print-jetson-holder-boven.STL, 3D-print-jetson-holder-onder.STL]
2023-12-12 readme update
    [sensor blok L V1.2.STL, sensor blok M V1.2.STL, sensor blok R V1.2.STL]
